nahhao74/QUIZ_Remote/hardware/schematic/M1_BATTERY_MAIN_SWITCH.png

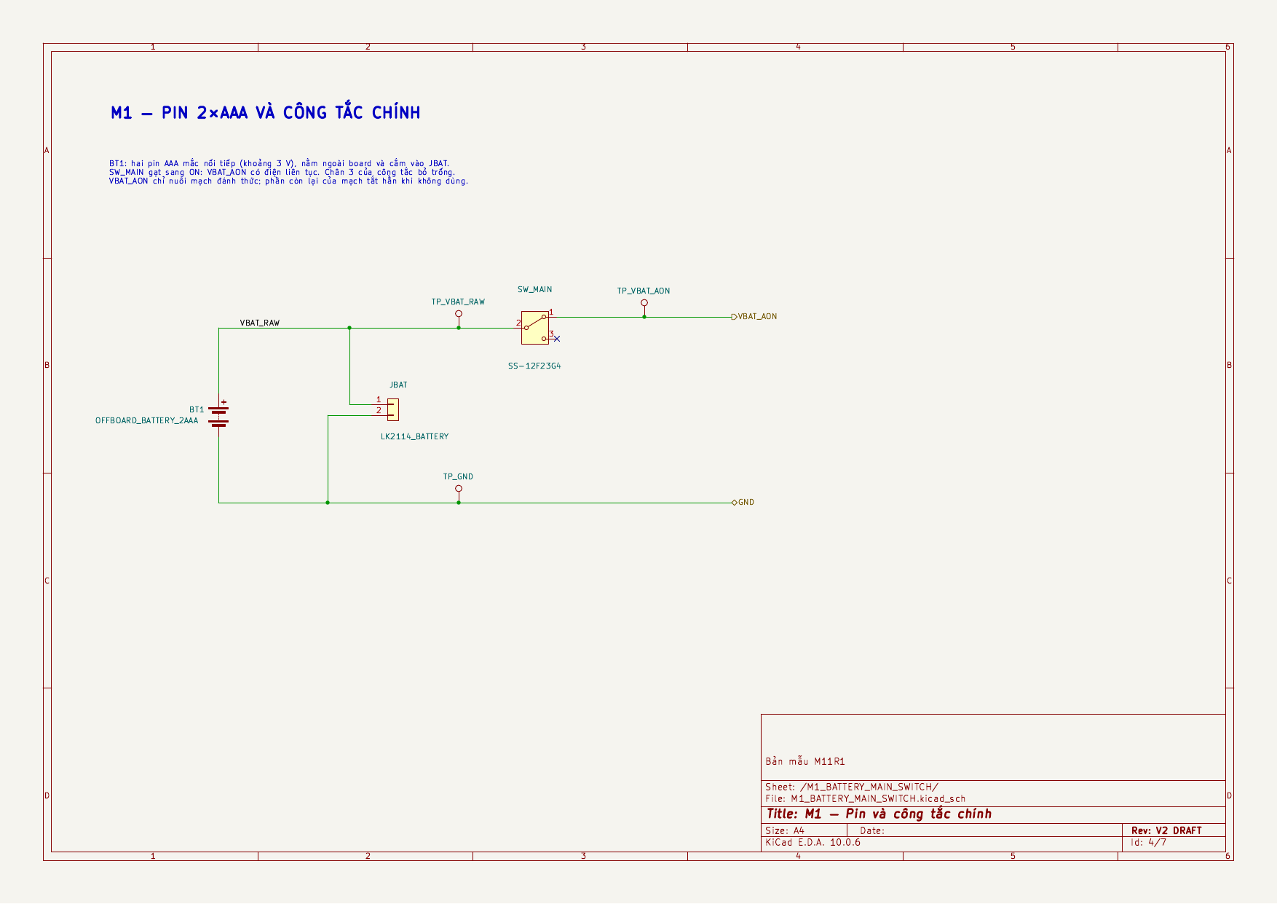
hardware/schematic/M1_BATTERY_MAIN_SWITCH.png
