nahhao74/QUIZ_Remote/hardware/schematic/M2_POWER_GATE_WAKE_HOLD.png

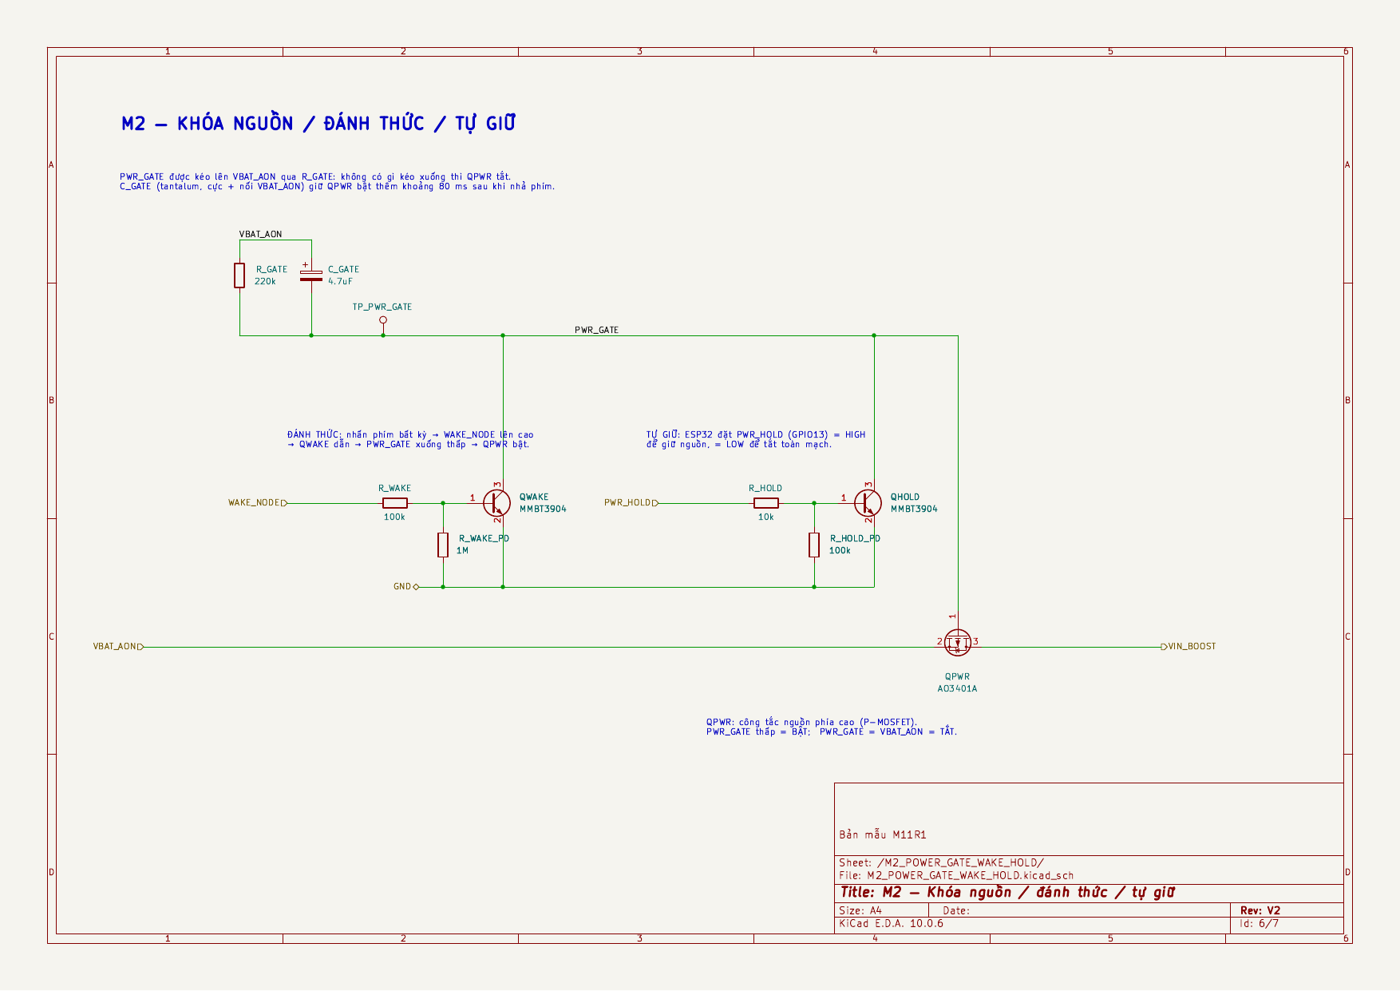
hardware/schematic/M2_POWER_GATE_WAKE_HOLD.png
