nahhao74/QUIZ_Remote/hardware/schematic/M3_BOOST_3V3.png

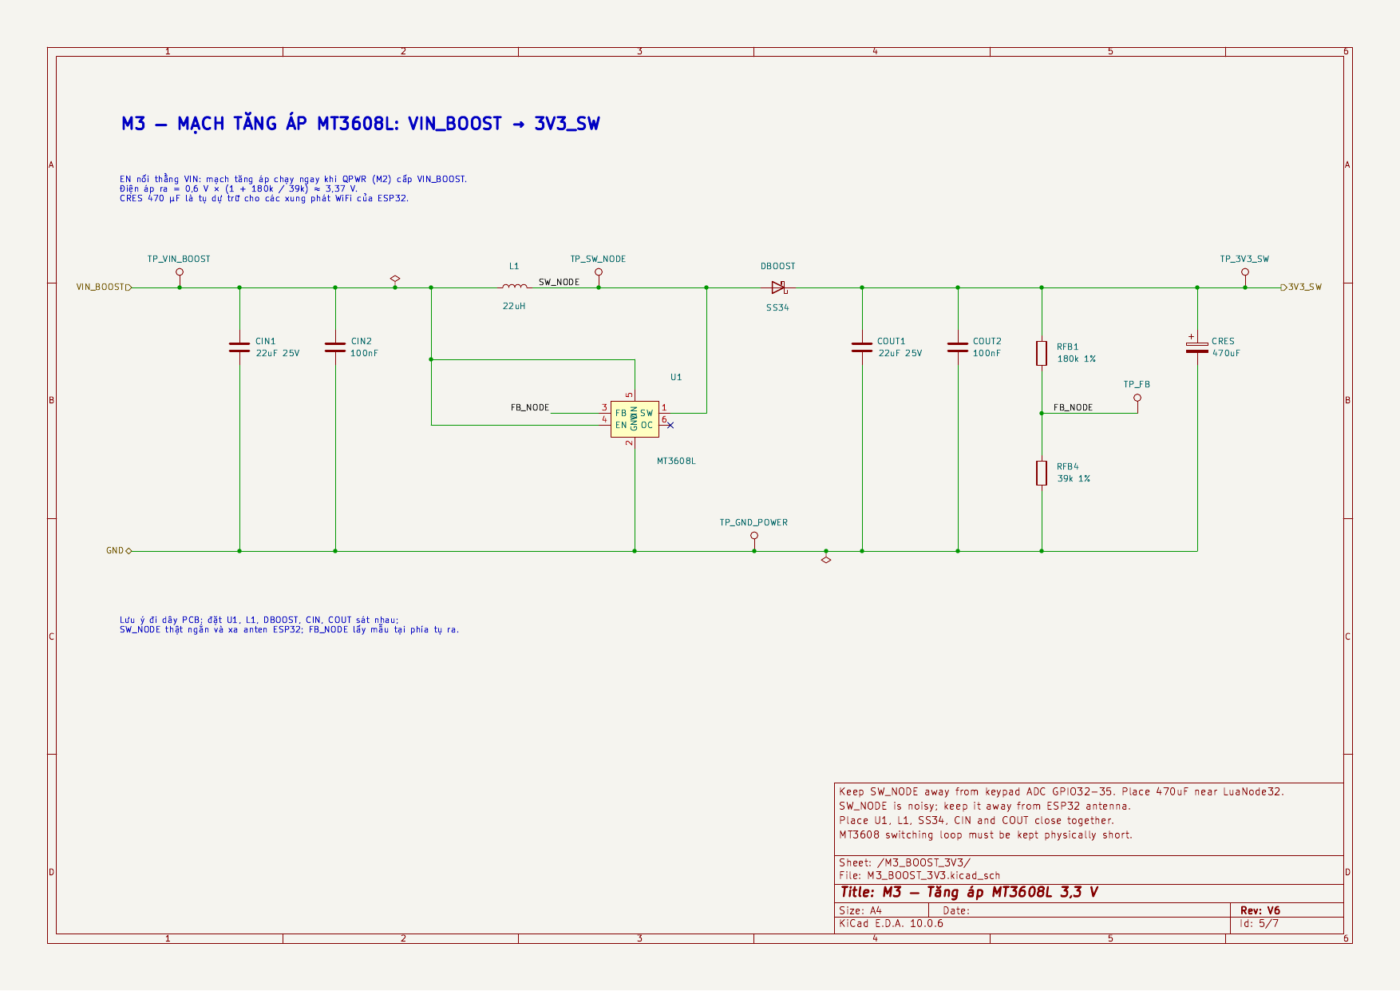
hardware/schematic/M3_BOOST_3V3.png
