nahhao74/QUIZ_Remote/hardware/schematic/M4_ESP32_SOCKET.png

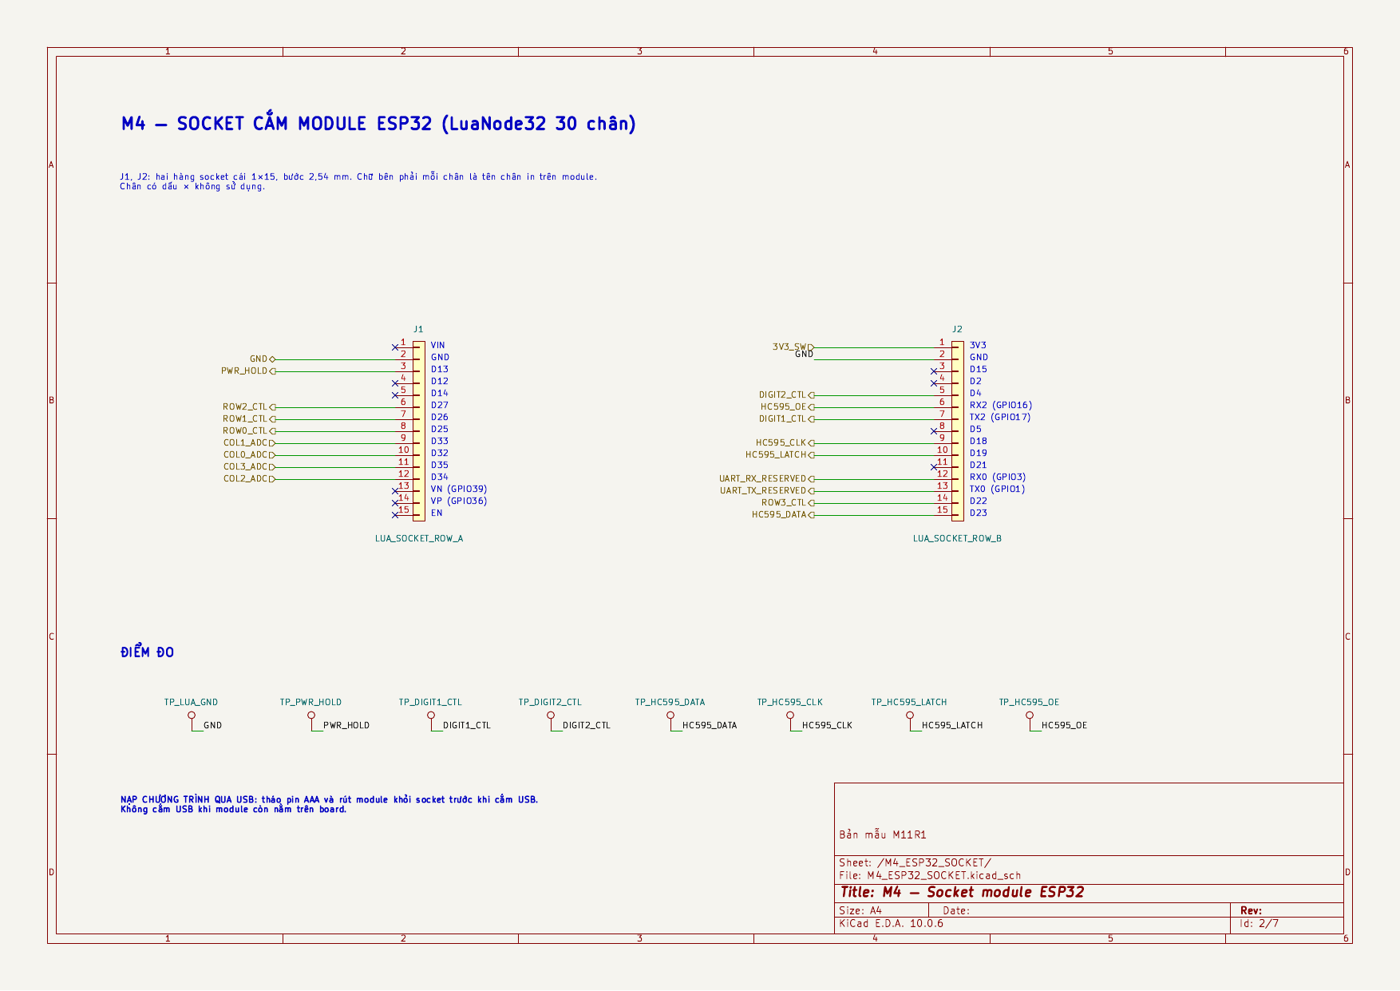
hardware/schematic/M4_ESP32_SOCKET.png
