nahhao74/QUIZ_Remote/hardware/schematic/M5_KEYPAD_4X4.png

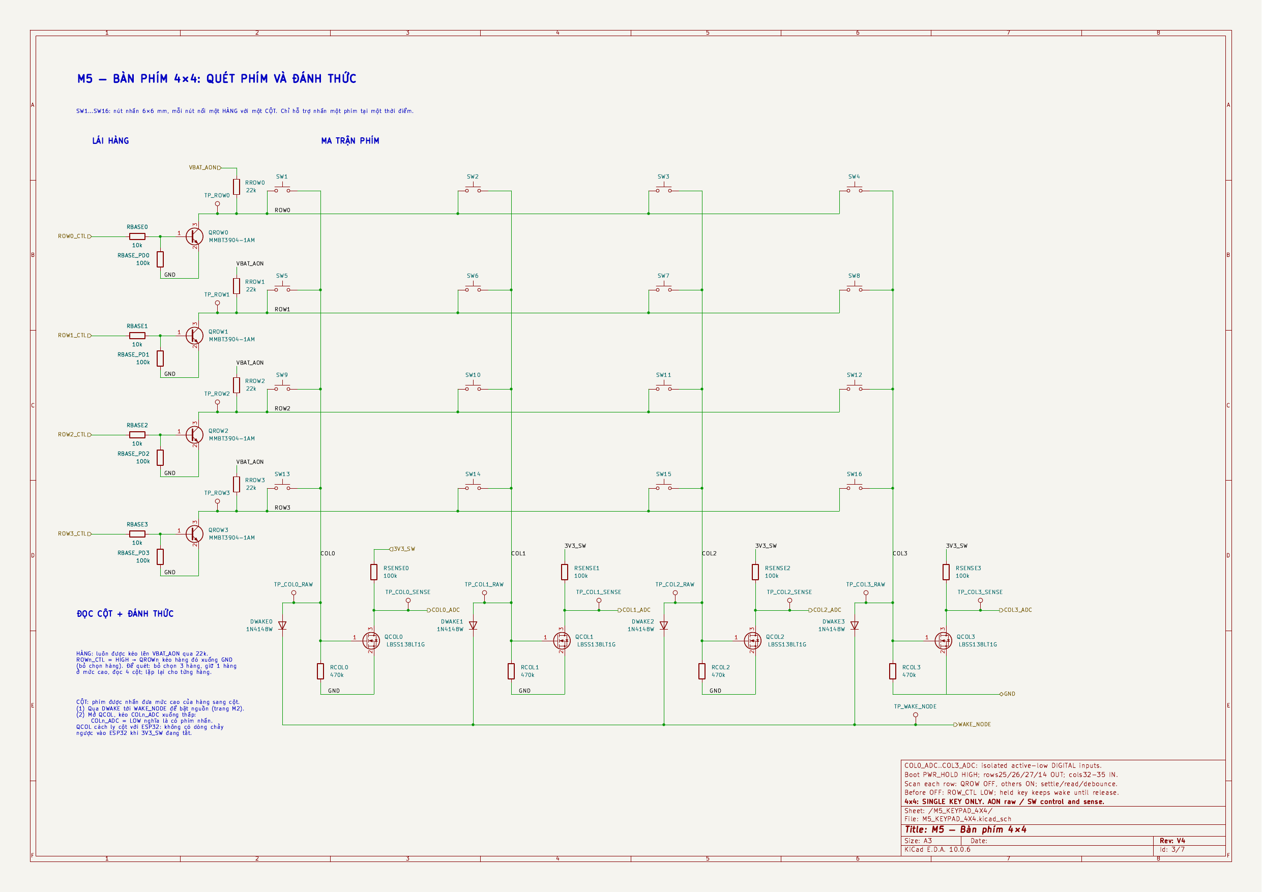
hardware/schematic/M5_KEYPAD_4X4.png
