nahhao74/QUIZ_Remote/hardware/schematic/M6_DISPLAY_2DIGIT.png

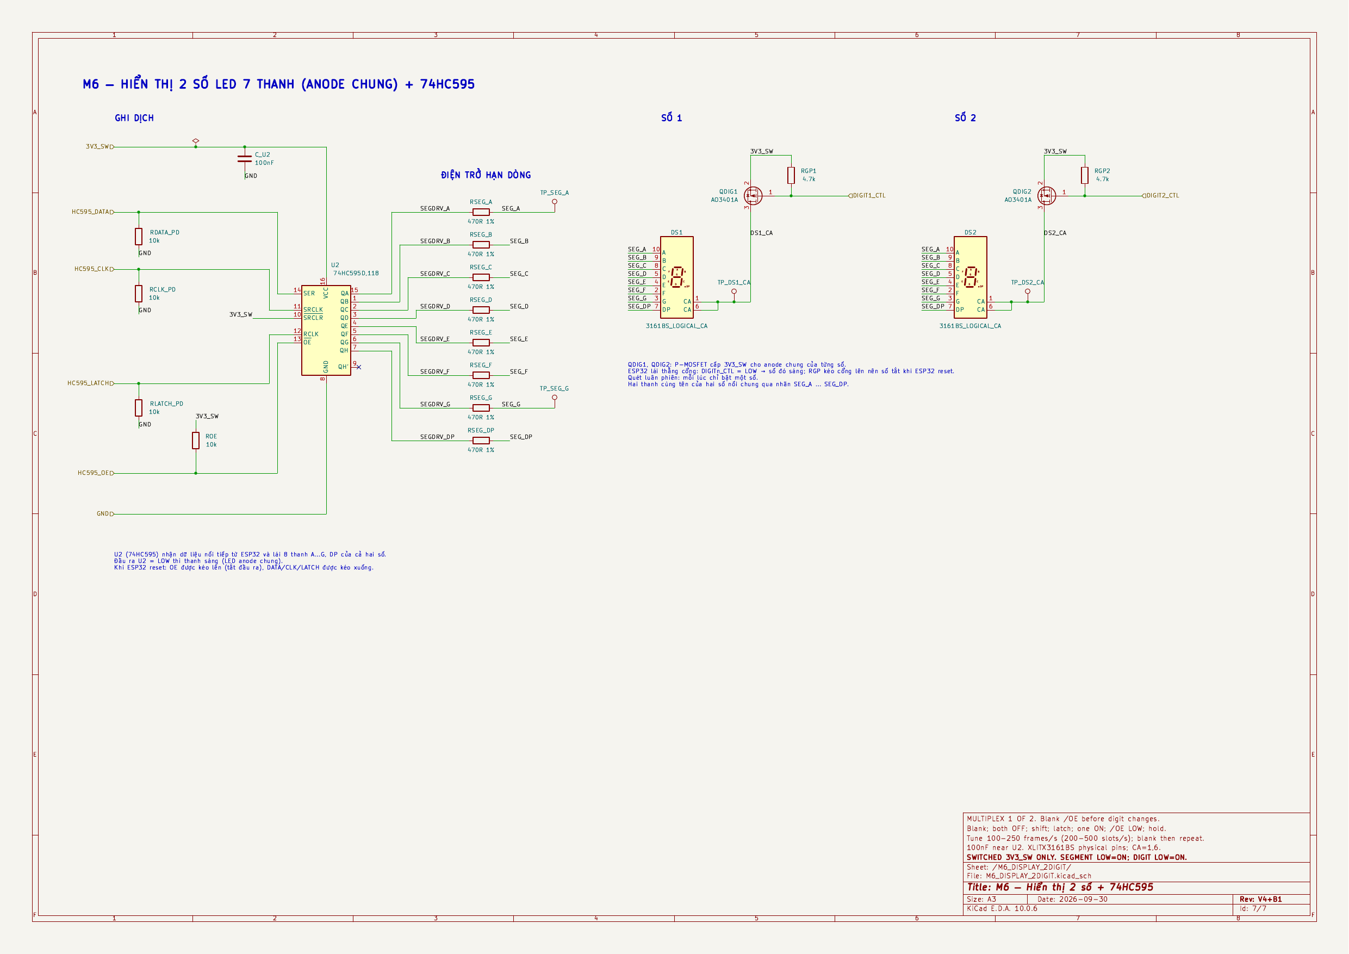
hardware/schematic/M6_DISPLAY_2DIGIT.png
