nahhao74/QUIZ_Remote/hardware/single-layer/exports/pcb-back.png

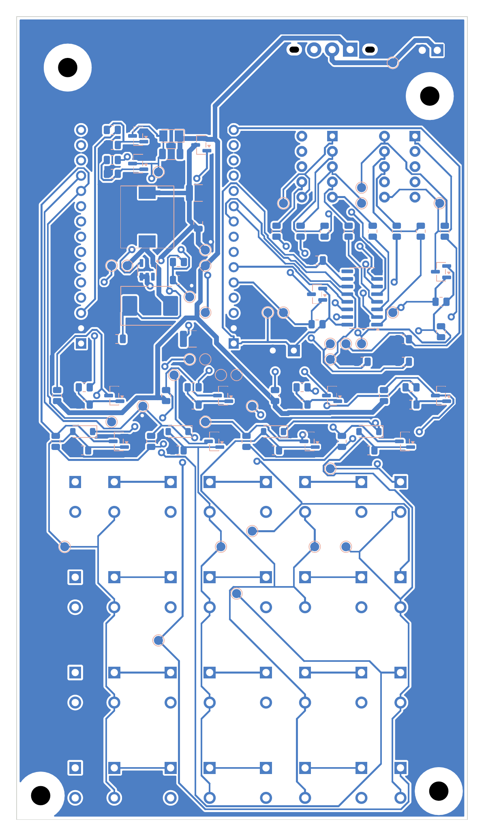
hardware/single-layer/exports/pcb-back.png
