nahhao74/QUIZ_Remote/hardware/single-layer/exports/pcb-front.png

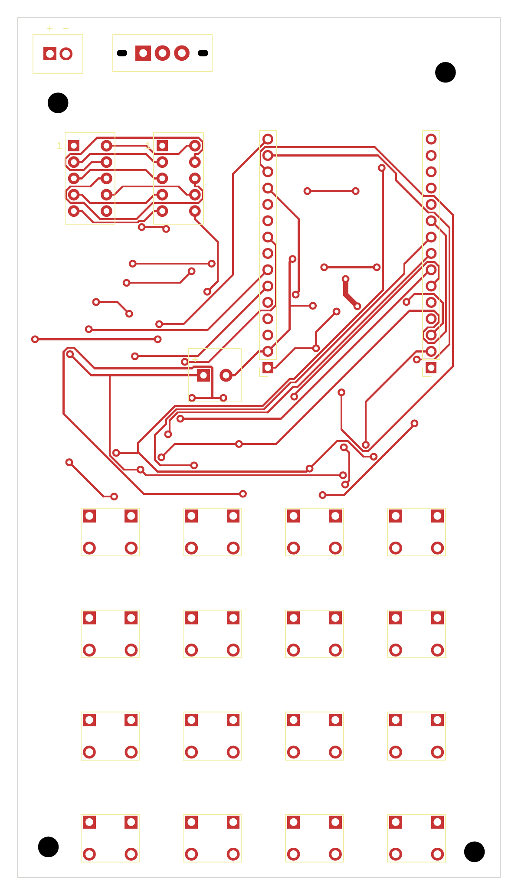
hardware/single-layer/exports/pcb-front.png
