nahhao74/QUIZ_Remote/hardware/single-layer/route/render_back.png

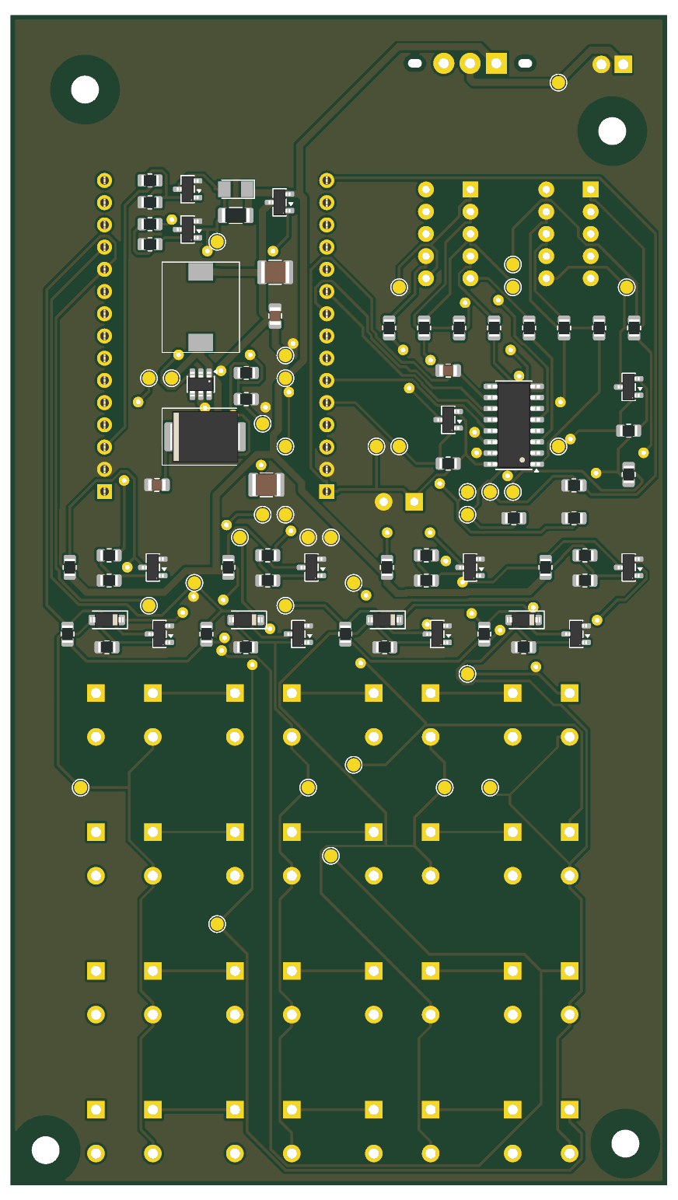
hardware/single-layer/route/render_back.png
