nahhao74/QUIZ_Remote/quiz_remote_1layer/route/jumpers.png

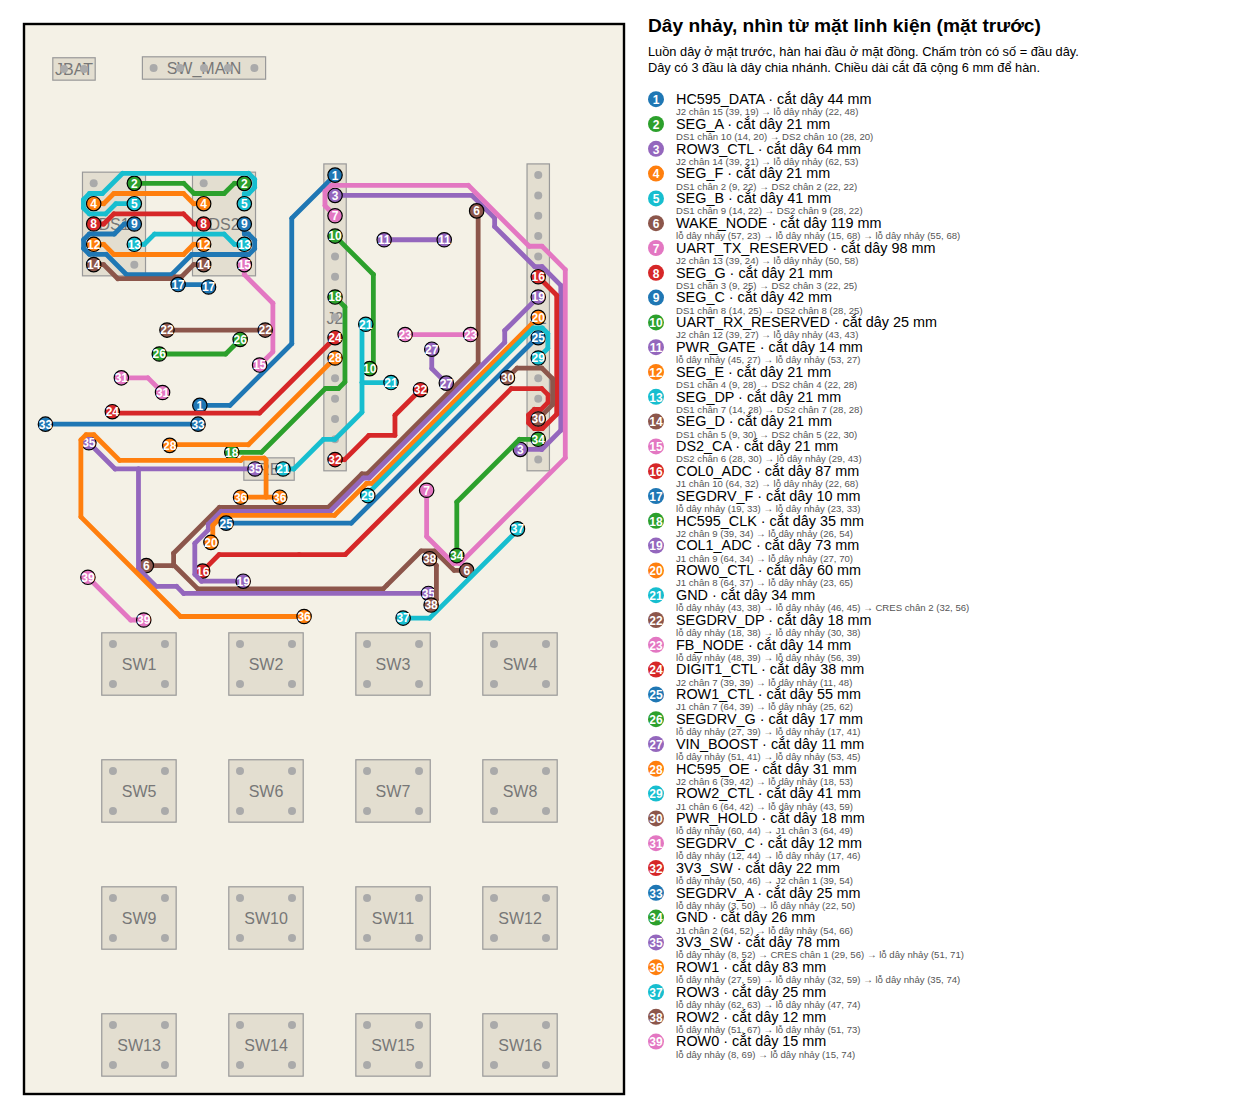
quiz_remote_1layer/route/jumpers.png
