nahhao74/QUIZ_Remote/quiz_remote_1layer/route/render_front.png

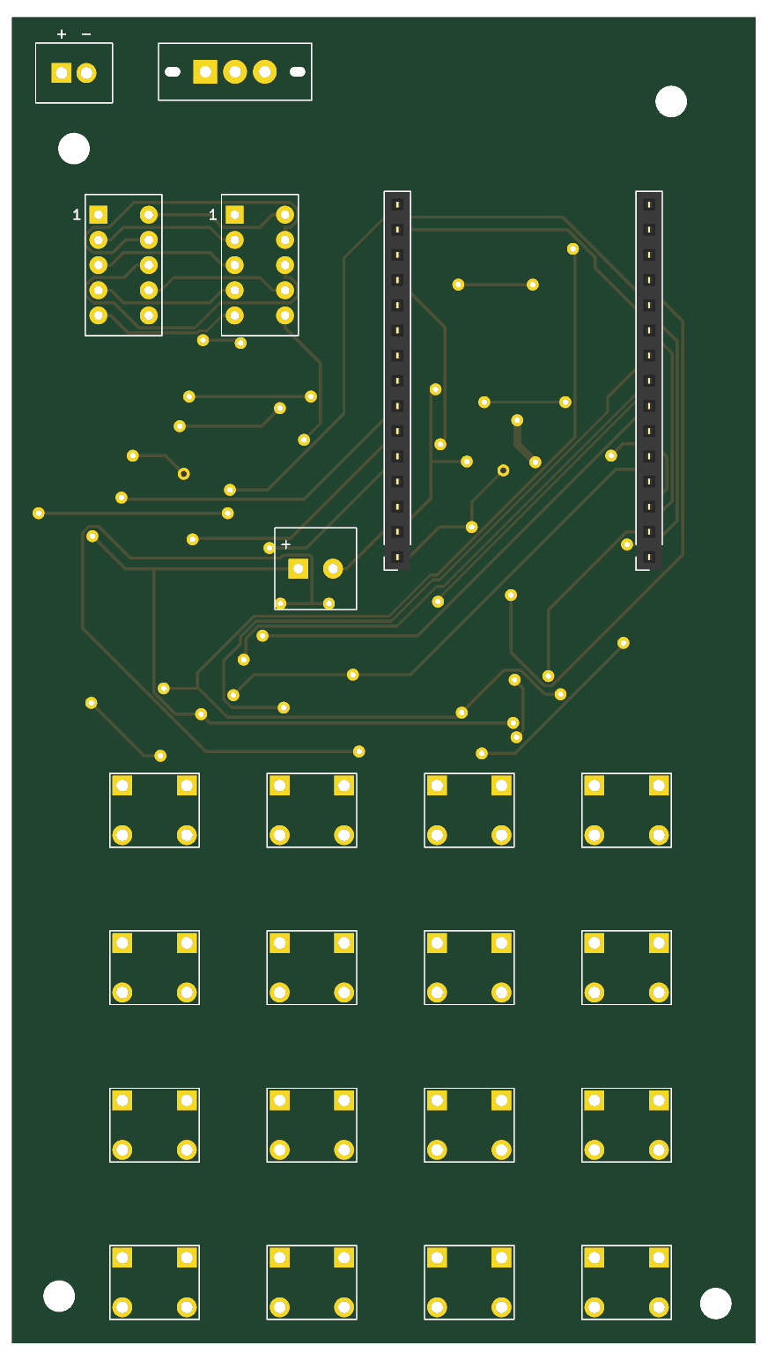
quiz_remote_1layer/route/render_front.png
