nahhao74/QUIZ_Remote/quiz_remote_compact/route/render_front.png

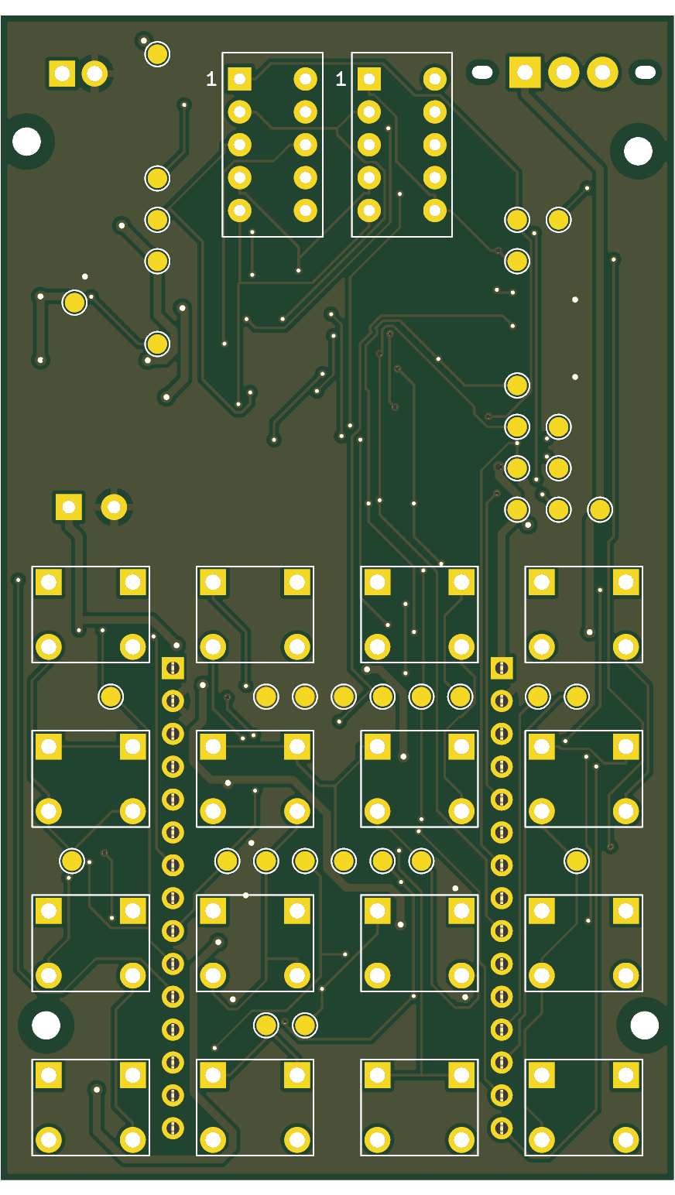
quiz_remote_compact/route/render_front.png
