nahhao74/QUIZ_Remote/hardware/compact/bom.csv

Reference | Value | Footprint | Qty | Datasheet
BT1 | OFFBOARD_BATTERY_2AAA |  | 1 | https://www.thegioiic.com/hop-pin-khay-pin-2xaaa-day-noi-dai-15cm
CIN1,COUT1 | 22uF 25V | Capacitor_SMD:C_1210_3225Metric | 2
CIN2,COUT2,C_U2 | 100nF | Capacitor_SMD:C_0805_2012Metric | 3 | https://search.kemet.com/download/specsheet/C0805C104K5RACTU
CRES? | 470uF | quiz_remote_physical:CRES_IC4172_D8_P3.50_Prototype | 1 | https://www.thegioiic.com/tu-hoa-470uf-16v-8x12-5mm-xuyen-lo
C_GATE? | 4.7uF | quiz_remote_physical:CP_AVX_TAJ_A_3216_18 | 1 | https://datasheets.kyocera-avx.com/TAJ.pdf
DBOOST? | SS34 | Diode_SMD:D_SMC | 1 | https://www.vishay.com/docs/88751/ss32.pdf
DS1,DS2 | 3161BS_LOGICAL_CA | quiz_remote_physical:Display_XLITX_3161BS | 2 | https://www.xlitx.com/datasheet/3161BS.pdf
DWAKE0-DWAKE3 | 1N4148W | Diode_SMD:D_SOD-123 | 4 | https://www.vishay.com/docs/85748/1n4148w.pdf
J1 | LUA_SOCKET_ROW_A | Connector_PinSocket_2.54mm:PinSocket_1x15_P2.54mm_Vertical | 1
J2 | LUA_SOCKET_ROW_B | Connector_PinSocket_2.54mm:PinSocket_1x15_P2.54mm_Vertical | 1
JBAT? | LK2114_BATTERY | quiz_remote_physical:JBAT_LK2114_P2.50_Prototype | 1 | https://file.linhkienx.com/upload/large/4576.jpg
L1 | 22uH | quiz_remote_physical:L_8D43_220_ThegioiIC | 1 | https://file.thegioiic.com/upload/large/3406.jpg
QCOL0-QCOL3 | LBSS138LT1G | Package_TO_SOT_SMD:SOT-23 | 4 | https://www.lrc.cn/Upload/PDF/Product/MOS/LBSS138LT1G.pdf
QDIG1,QDIG2,QPWR? | AO3401A | Package_TO_SOT_SMD:SOT-23 | 3 | https://www.aosmd.com/res/data_sheets/AO3401A.pdf
QHOLD?,QWAKE? | MMBT3904 | Package_TO_SOT_SMD:SOT-23 | 2 | https://assets.nexperia.com/documents/data-sheet/MMBT3904.pdf
QROW0-QROW3 | MMBT3904-1AM | Package_TO_SOT_SMD:SOT-23 | 4 | https://assets.nexperia.com/documents/data-sheet/MMBT3904.pdf
RBASE0-RBASE3,RCLK_PD?,RDATA_PD?,RLATCH_PD?,ROE?,R_HOLD? | 10k | Resistor_SMD:R_0805_2012Metric | 9 | https://www.kstmicro.com/wp-content/uploads/2024/07/PYu-RC_Group_51_RoHS_L_12-14.pdf
RBASE_PD0-RBASE_PD3,RSENSE0-RSENSE3,R_HOLD_PD?,R_WAKE? | 100k | Resistor_SMD:R_0805_2012Metric | 10 | https://www.kstmicro.com/wp-content/uploads/2024/07/PYu-RC_Group_51_RoHS_L_12-14.pdf
RCOL0-RCOL3 | 470k | Resistor_SMD:R_0805_2012Metric | 4 | https://www.kstmicro.com/wp-content/uploads/2024/07/PYu-RC_Group_51_RoHS_L_12-14.pdf
RFB1 | 180k 1% | Resistor_SMD:R_0805_2012Metric | 1 | https://www.kstmicro.com/wp-content/uploads/2024/07/PYu-RC_Group_51_RoHS_L_12-14.pdf
RFB4 | 39k 1% | Resistor_SMD:R_0805_2012Metric | 1 | https://www.kstmicro.com/wp-content/uploads/2024/07/PYu-RC_Group_51_RoHS_L_12-14.pdf
RGP1,RGP2 | 4.7k | Resistor_SMD:R_0805_2012Metric | 2 | https://www.kstmicro.com/wp-content/uploads/2024/07/PYu-RC_Group_51_RoHS_L_12-14.pdf
RROW0-RROW3 | 22k | Resistor_SMD:R_0805_2012Metric | 4 | https://www.kstmicro.com/wp-content/uploads/2024/07/PYu-RC_Group_51_RoHS_L_12-14.pdf
RSEG_A?,RSEG_B?,RSEG_C?,RSEG_D?,RSEG_DP?,RSEG_E?,RSEG_F?,RSEG_G? | 470R 1% | Resistor_SMD:R_0805_2012Metric | 8 | https://www.kstmicro.com/wp-content/uploads/2024/07/PYu-RC_Group_51_RoHS_L_12-14.pdf
R_GATE? | 220k | Resistor_SMD:R_1206_3216Metric | 1 | https://www.kstmicro.com/wp-content/uploads/2024/07/PYu-RC_Group_51_RoHS_L_12-14.pdf
R_WAKE_PD? | 1M | Resistor_SMD:R_0805_2012Metric | 1 | https://www.kstmicro.com/wp-content/uploads/2024/07/PYu-RC_Group_51_RoHS_L_12-14.pdf
SW1-SW16 | 6x6_THT_NO | quiz_remote_physical:SW_6x6_H4.3_LK14489 | 16 | https://file.linhkienx.com/upload/large/12028.jpg
SW_MAIN? | SS-12F23G4 | quiz_remote_physical:SW_SS12F23G4_LK | 1 | https://file.linhkienx.com/upload/large/1343.jpg
U1 | MT3608L | Package_TO_SOT_SMD:SOT-23-6 | 1 | https://datasheet.lcsc.com/datasheet/pdf/28bde6b2f6a53c067ef18a25e9ffed22.pdf?productCode=C2932326
U2 | 74HC595D,118 | Package_SO:SOIC-16_3.9x9.9mm_P1.27mm | 1 | https://assets.nexperia.com/documents/data-sheet/74HC_HCT595.pdf
