nahhao74/QUIZ_Remote/web/docs/hardware/bom-breadboard.csv

Ref | Quantity | Component | Value / type | Notes
U1 | 1 | ESP32 DevKit 30 pin | ESP32-WROOM-32 | Already owned
DISP1-DISP2 | 2 | 4-digit 7-segment LED module | 74HC595 5-pin | Already owned; VCC 3V3 for testing
K1 | 1 | 4x4 membrane keypad | 8 wires | Already owned
LED1 | 1 | Red LED | SMD 0805 | Add when building the full circuit
LED2 | 1 | Green LED | SMD 0805 or through-hole | Already owned
R1-R4 | 4 | Keypad row protection resistor | 1 kOhm 1/4 W | For the full circuit
R5-R8 | 4 | Keypad column pull-down resistor | 47 kOhm 1/4 W | For the full circuit
R9-R10 | 2 | LED series resistor | 1 kOhm 1/4 W; temporarily 330 Ohm for the green LED | One per LED
C1 | 1 | Power input bulk capacitor | 470 uF 10 V | Recommended near the two displays
C2-C3 | 2 | Decoupling capacitor | 100 nF 50 V | Place near the VCC of each display if the module does not have one
BUF1 | 1 | Optional logic level buffer | 74AHCT125 | Only needed if the displays are powered from 5 V
PS1 | 1 | USB power supply | 5 V at least 1 A | Powers the ESP32; take 3V3 from the board when testing
J1 | 1 | Keypad header | 1x8 2.54 mm | For breadboard/PCB
J2-J3 | 2 | Display header | 1x5 2.54 mm | In the order printed on the module
