nahhao74/QUIZ_Remote/hardware/compact/route/solder_back.png

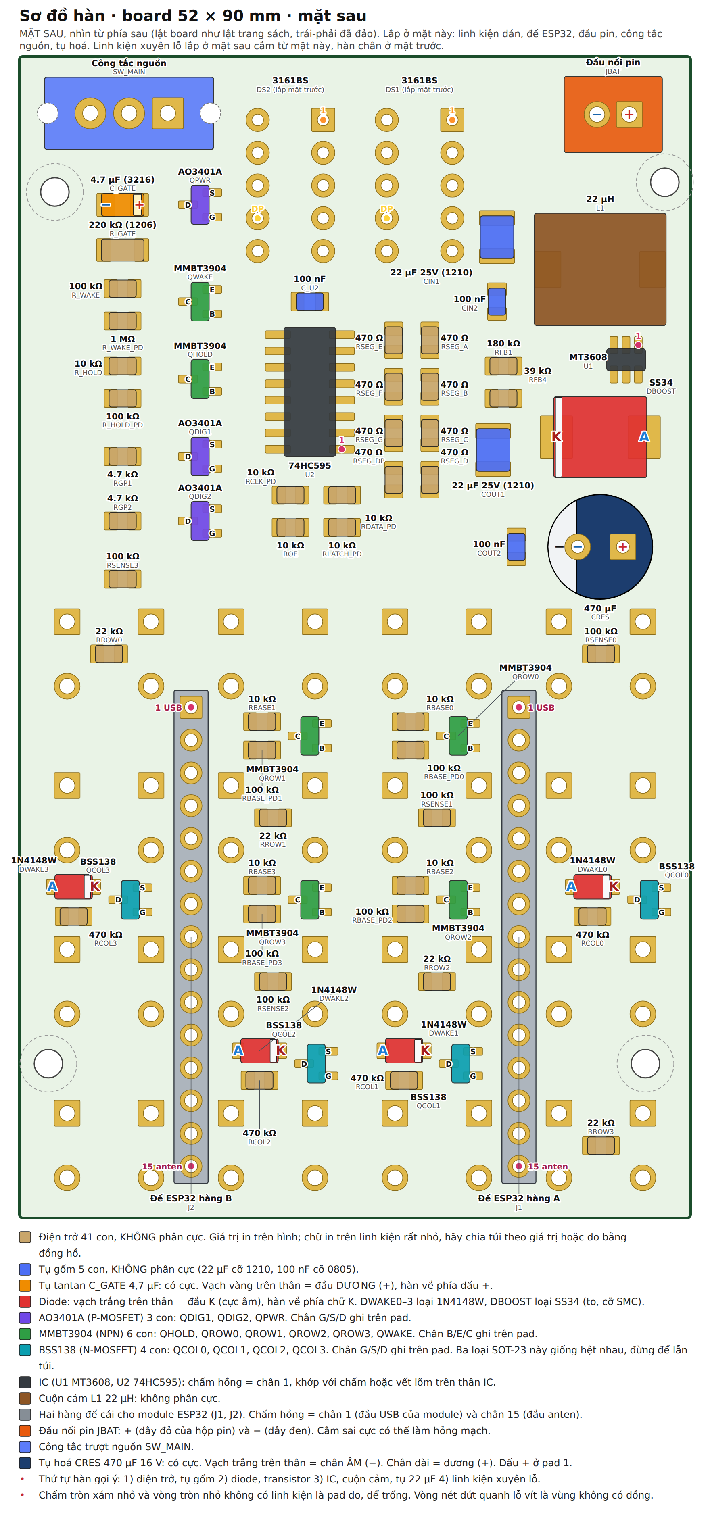
hardware/compact/route/solder_back.png
