nahhao74/QUIZ_Remote/hardware/compact/route/solder_front.png

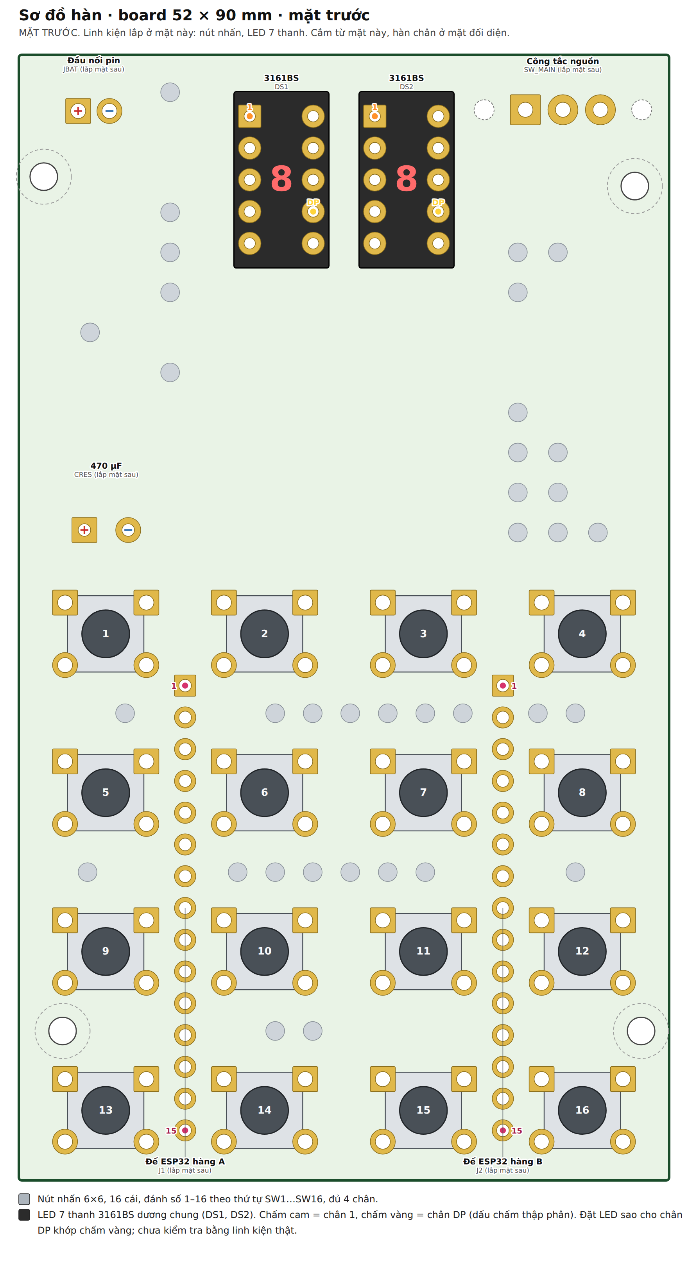
hardware/compact/route/solder_front.png
