nahhao74/QUIZ_Remote/hardware/single-layer/route/solder_back.png

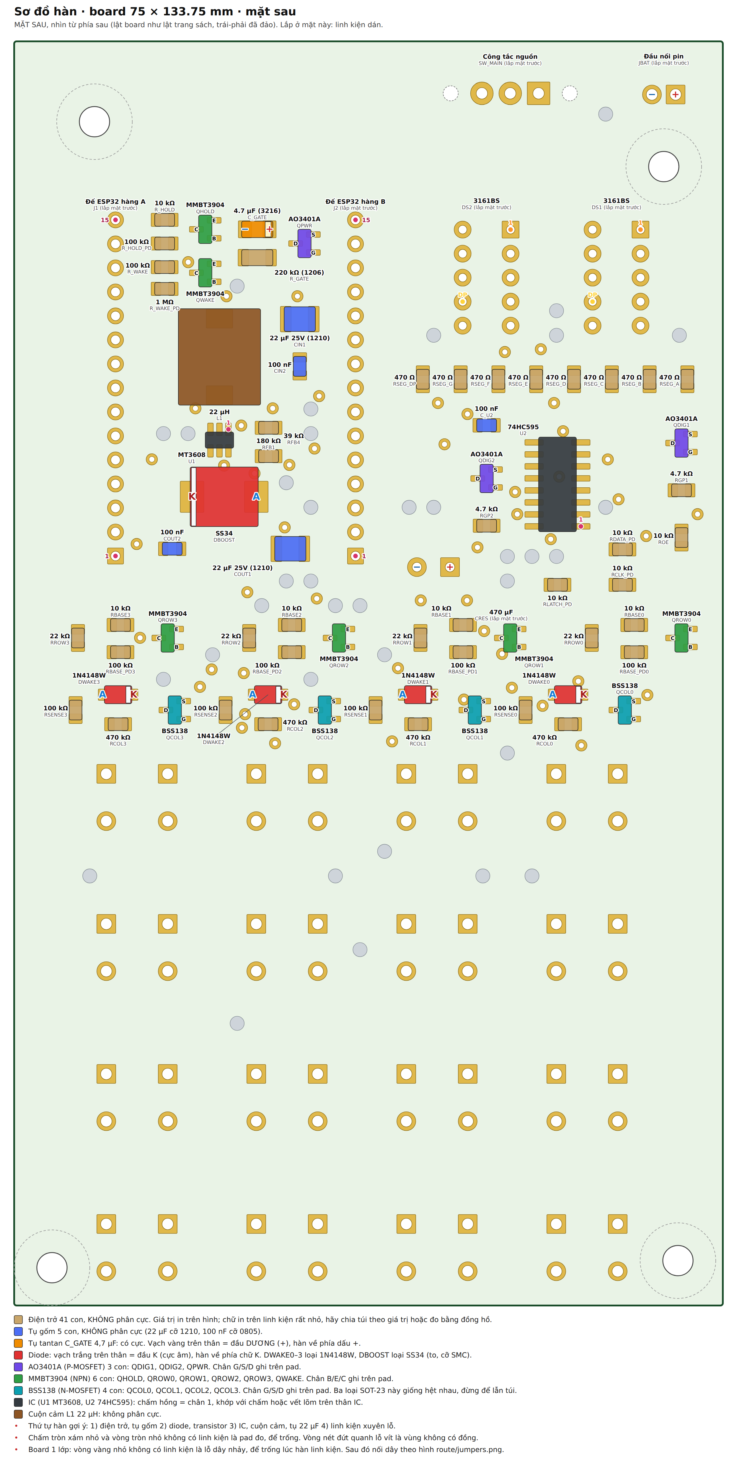
hardware/single-layer/route/solder_back.png
