nahhao74/QUIZ_Remote/hardware/single-layer/route/solder_front.png

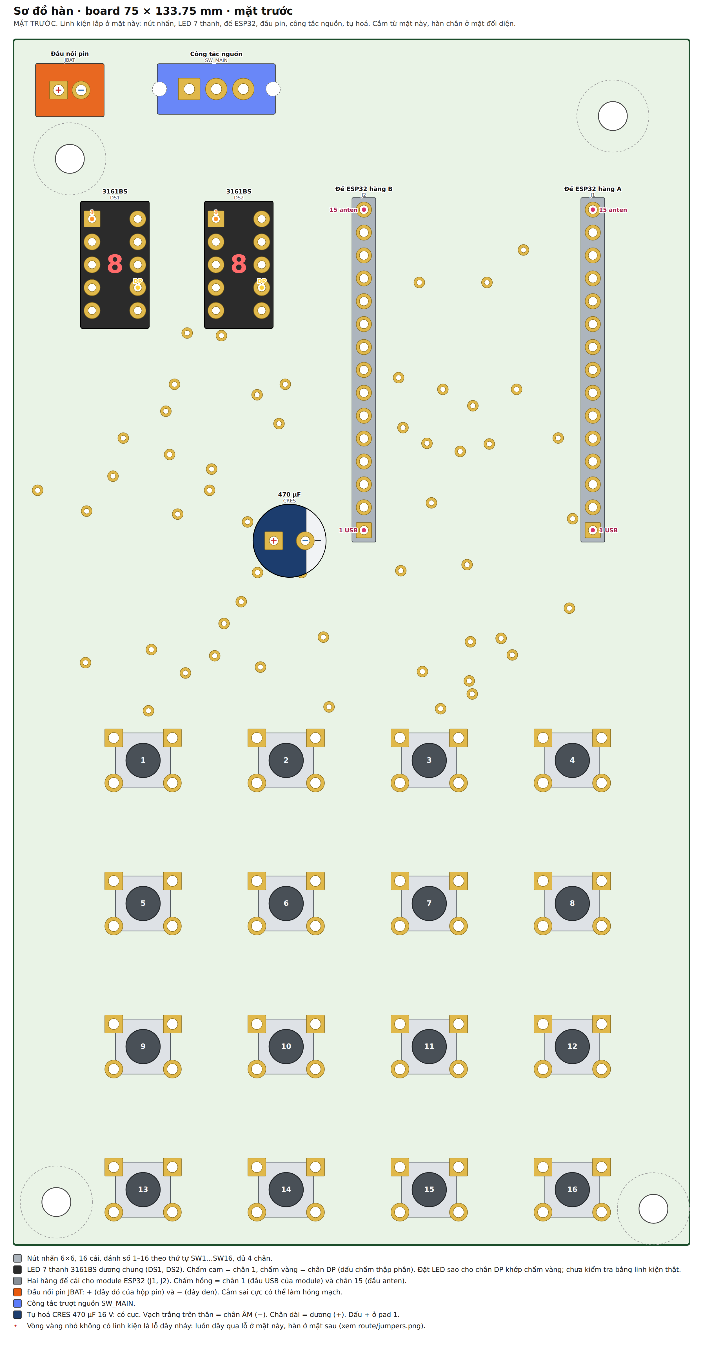
hardware/single-layer/route/solder_front.png
