nahhao74/QUIZ_Remote/hardware/schematic/M1_BATTERY_MAIN_SWITCH.pdf

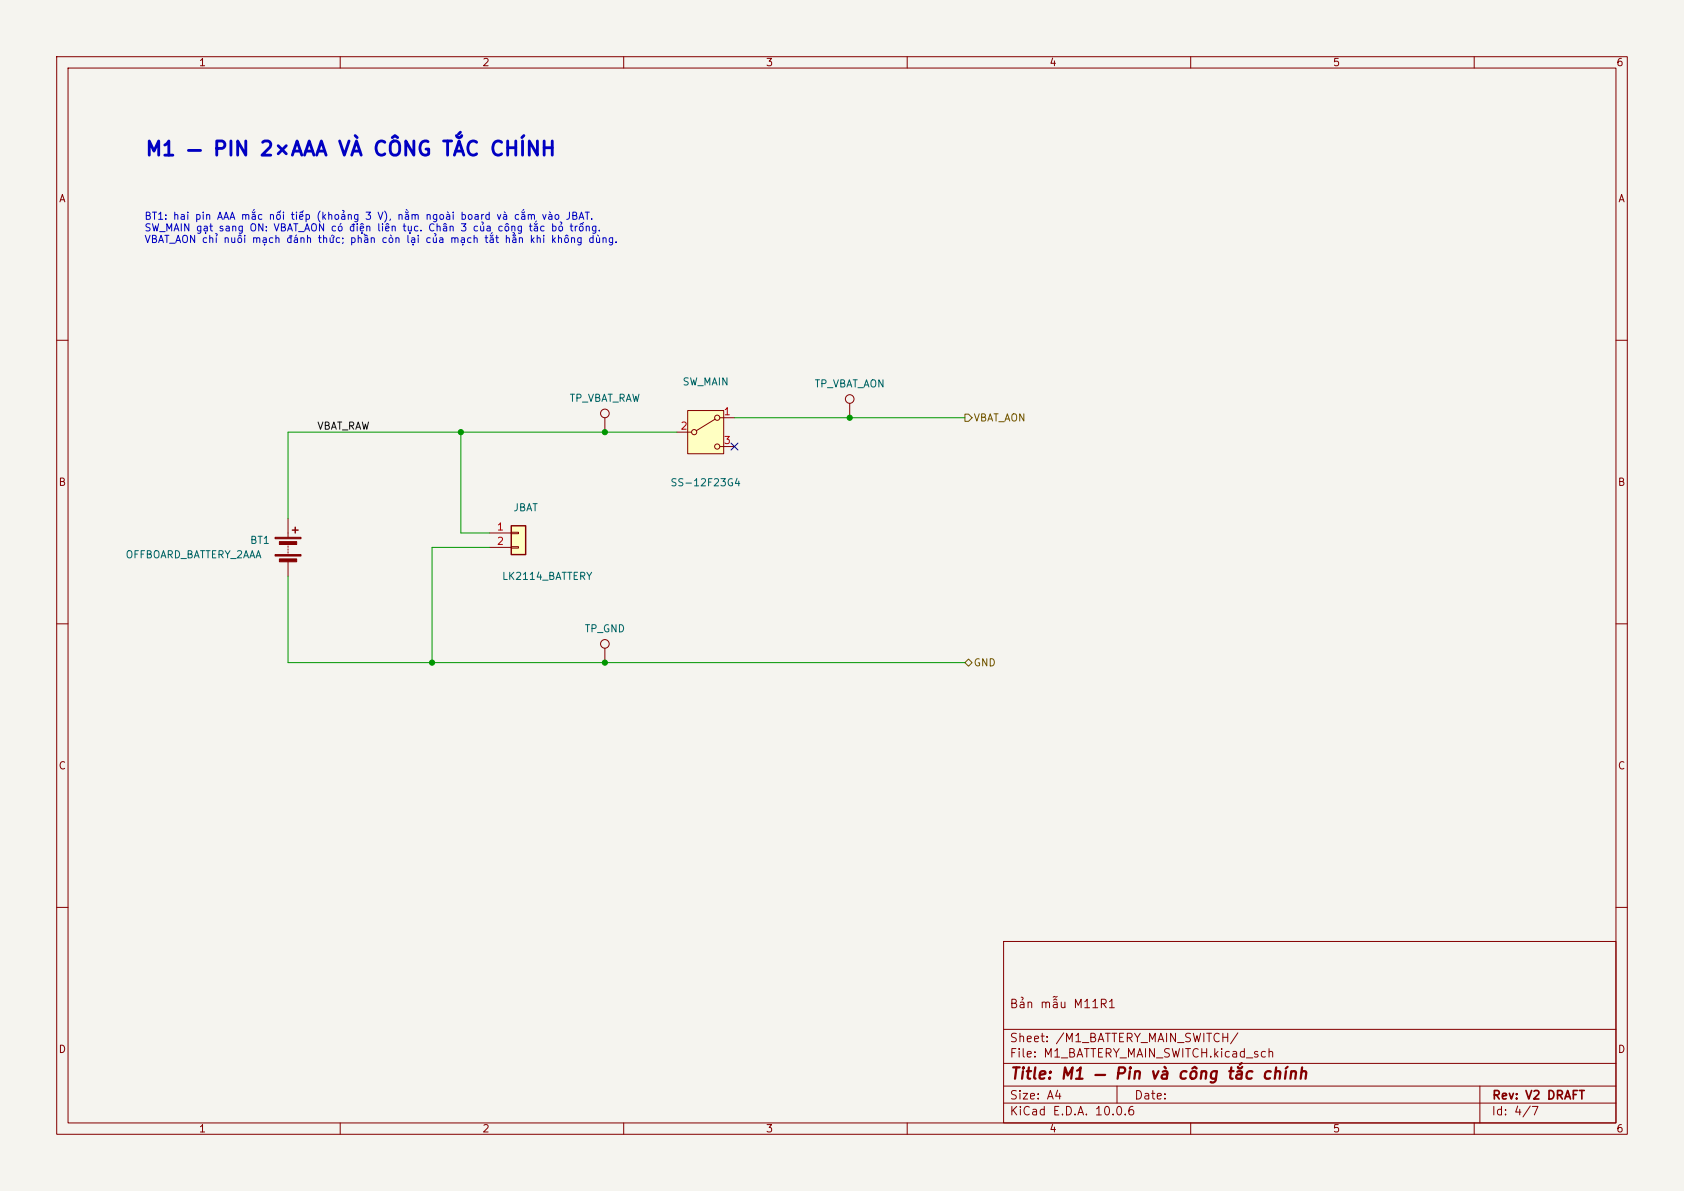
[picture p28: page 1]

VBAT_AON VBAT_RAW M1 — PIN 2×AAA VÀ CÔNG TẮC CHÍNH

BT1: hai pin AAA mắc nối tiếp (khoảng 3 V), nằm ngoài board và cắm vào JBAT. SW_MAIN gạt sang ON: VBAT_AON có điện liên tục. Chân 3 của công tắc bỏ trống. VBAT_AON chỉ nuôi mạch đánh thức; phần còn lại của mạch tắt hẳn khi không dùng.

Sheet: /M1_BATTERY_MAIN_SWITCH/
File: M1_BATTERY_MAIN_SWITCH.kicad_sch
Title: M1 — Pin và công tắc chính

Size: A4 | Rev: V2 DRAFT
KiCad E.D.A. 10.0.6 | Id: 4/7
