nahhao74/QUIZ_Remote/hardware/schematic/M2_POWER_GATE_WAKE_HOLD.pdf

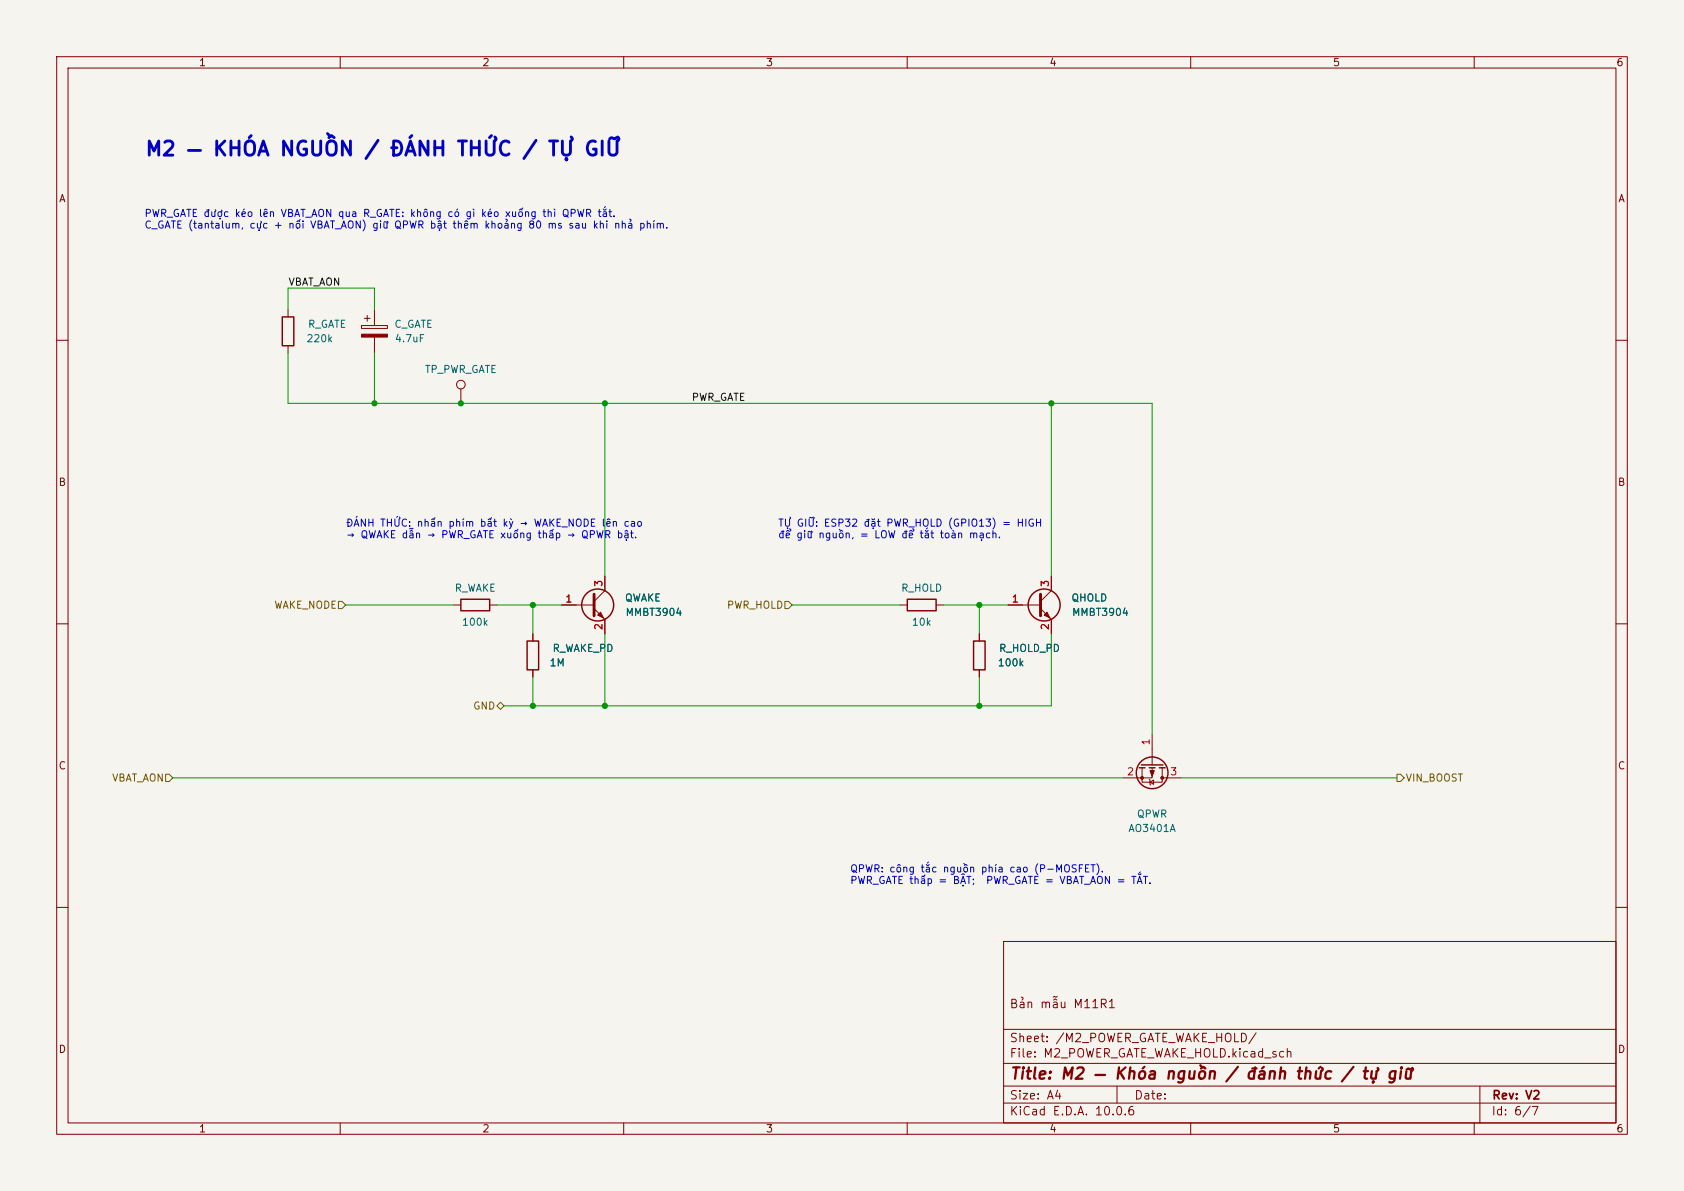
[picture p29: page 1]

M2 — KHÓA NGUỒN / ĐÁNH THỨC / TỰ GIỮ

để giữ nguồn, = LOW để tắt toàn mạch. PWR_GATE được kéo lên VBAT_AON qua R_GATE: không có gì kéo xuống thì QPWR tắt. C_GATE (tantalum, cực + nối VBAT_AON) giữ QPWR bật thêm khoảng 80 ms sau khi nhả phím.

PWR_GATE ĐÁNH THỨC: nhấn phím bất kỳ → WAKE_NODE lên cao → QWAKE dẫn → PWR_GATE xuống thấp → QPWR bật.

TỰ GIỮ: ESP32 đặt PWR_HOLD (GPIO13) = HIGH

Sheet: /M2_POWER_GATE_WAKE_HOLD/
File: M2_POWER_GATE_WAKE_HOLD.kicad_sch
Title: M2 — Khóa nguồn / đánh thức / tự giữ

Size: A4 | Rev: V2
KiCad E.D.A. 10.0.6 | Id: 6/7
