nahhao74/QUIZ_Remote/hardware/schematic/M3_BOOST_3V3.pdf

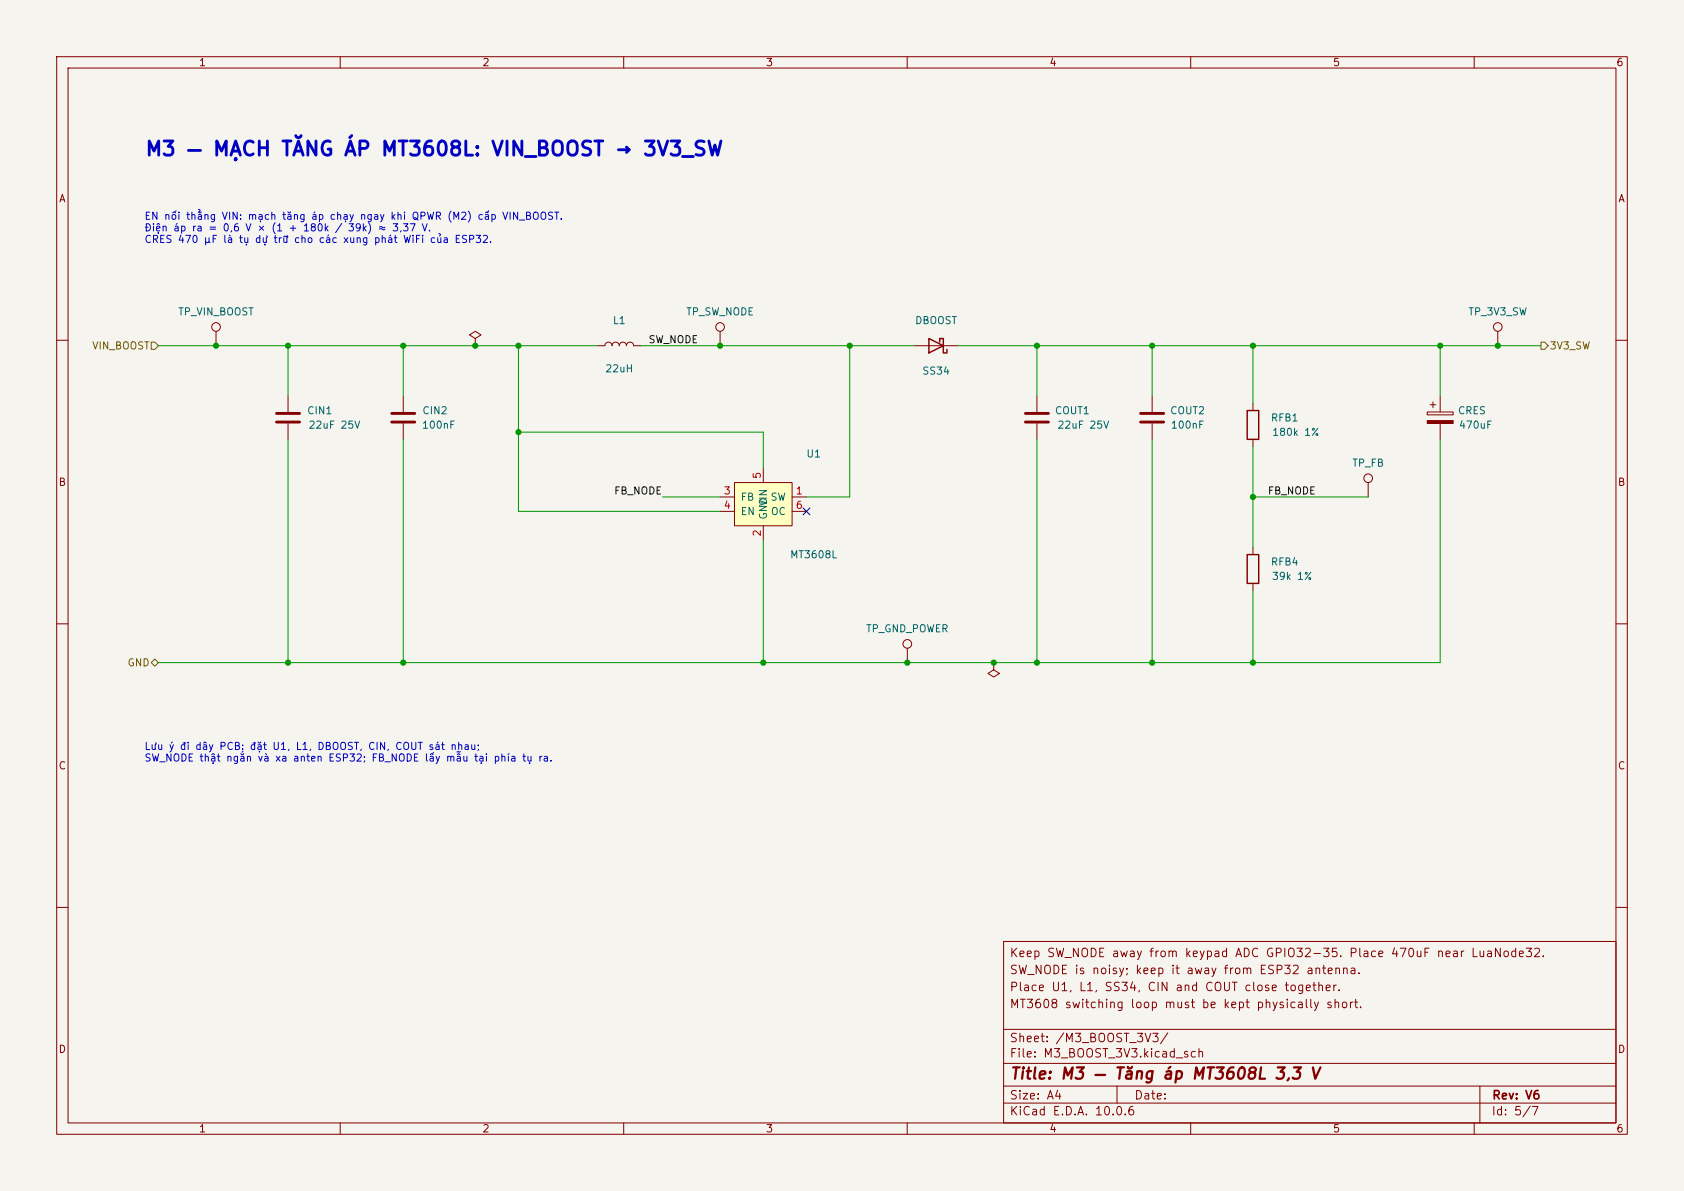
[picture p30: page 1]

EN nối thẳng VIN: mạch tăng áp chạy ngay khi QPWR (M2) cấp VIN_BOOST. Điện áp ra = 0,6 V × (1 + 180k / 39k) ≈ 3,37 V. CRES 470 µF là tụ dự trữ cho các xung phát WiFi của ESP32. M3 — MẠCH TĂNG ÁP MT3608L: VIN_BOOST → 3V3_SW

Lưu ý đi dây PCB: đặt U1, L1, DBOOST, CIN, COUT sát nhau; SW_NODE thật ngắn và xa anten ESP32; FB_NODE lấy mẫu tại phía tụ ra.

Keep SW_NODE away from keypad ADC GPIO32-35. Place 470uF near LuaNode32.
SW_NODE is noisy; keep it away from ESP32 antenna.
Place U1, L1, SS34, CIN and COUT close together.
MT3608 switching loop must be kept physically short.

Size: A4 | Rev: V6
KiCad E.D.A. 10.0.6 | Id: 5/7
