nahhao74/QUIZ_Remote/hardware/schematic/M4_ESP32_SOCKET.pdf

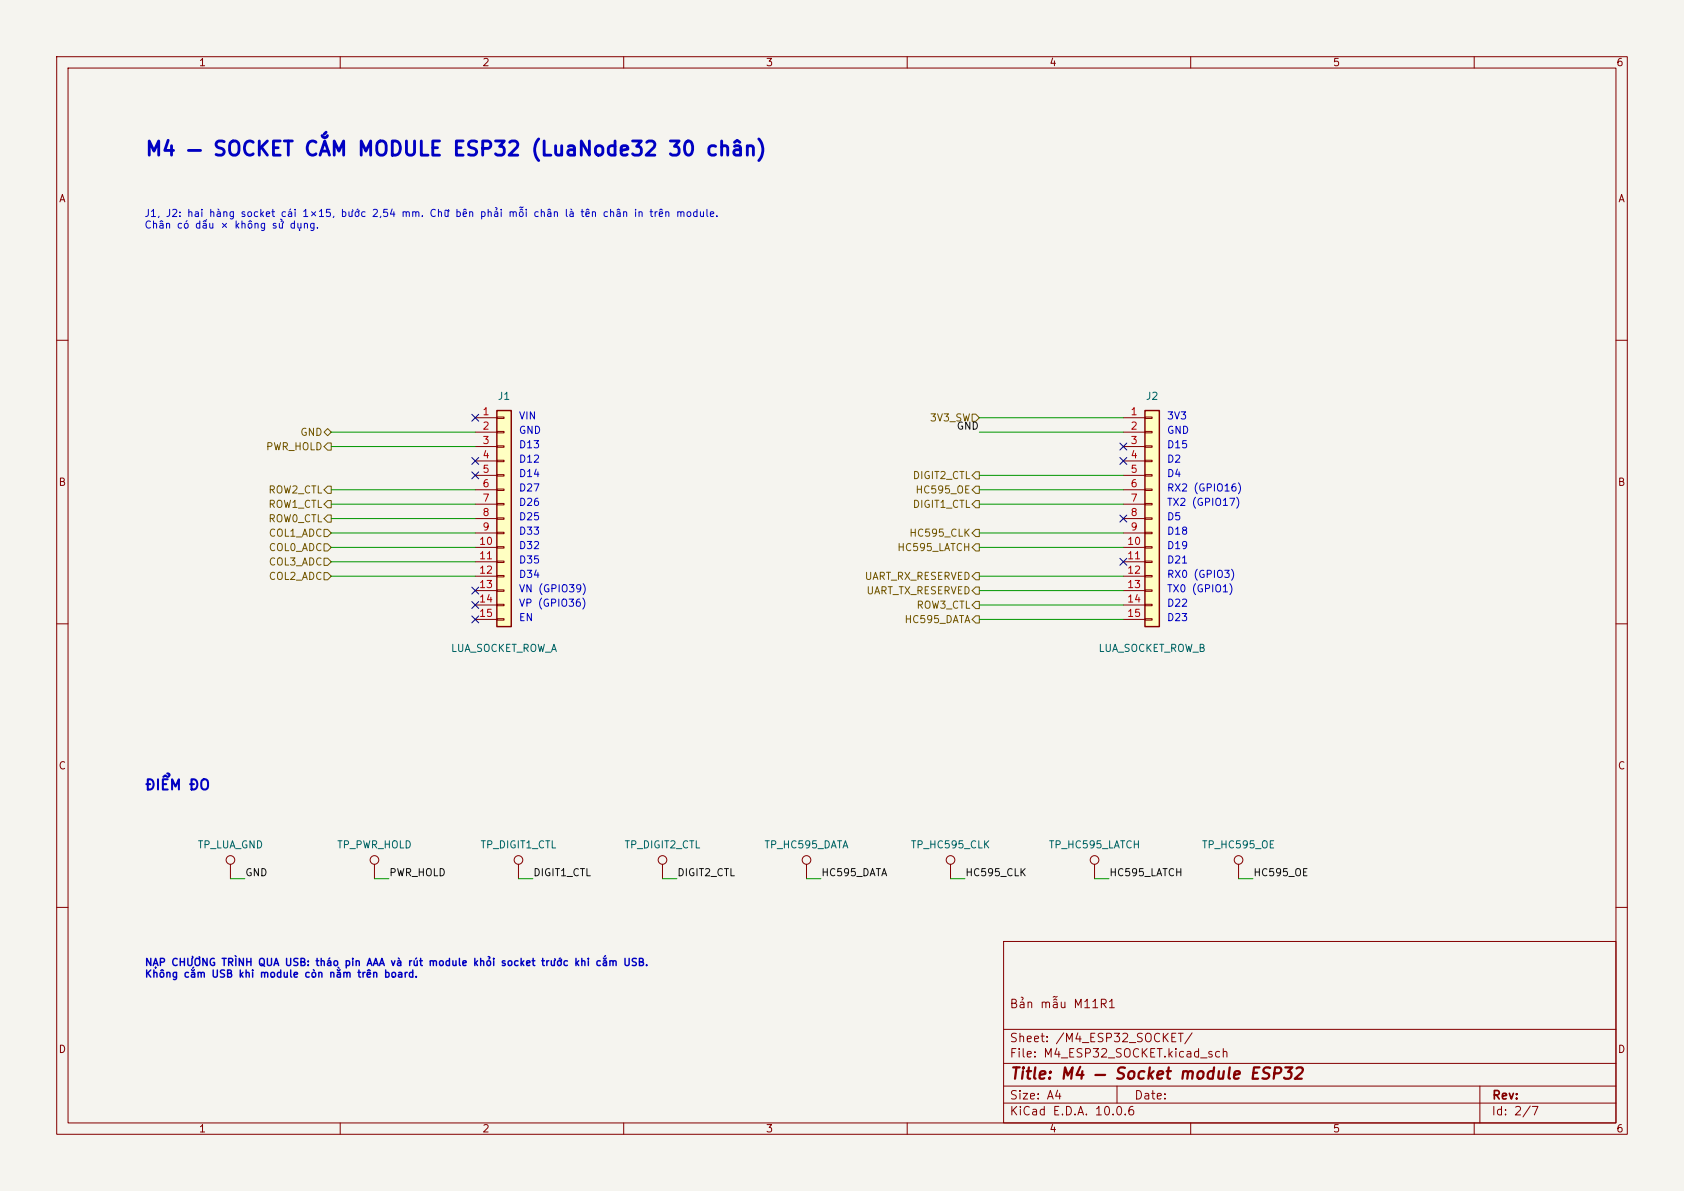
[picture p31: page 1]

M4 — SOCKET CẮM MODULE ESP32 (LuaNode32 30 chân)

J1, J2: hai hàng socket cái 1×15, bước 2,54 mm. Chữ bên phải mỗi chân là tên chân in trên module. Chân có dấu × không sử dụng.

Size: A4 | Rev:
KiCad E.D.A. 10.0.6 | Id: 2/7
