nahhao74/QUIZ_Remote/hardware/schematic/M6_DISPLAY_2DIGIT.pdf

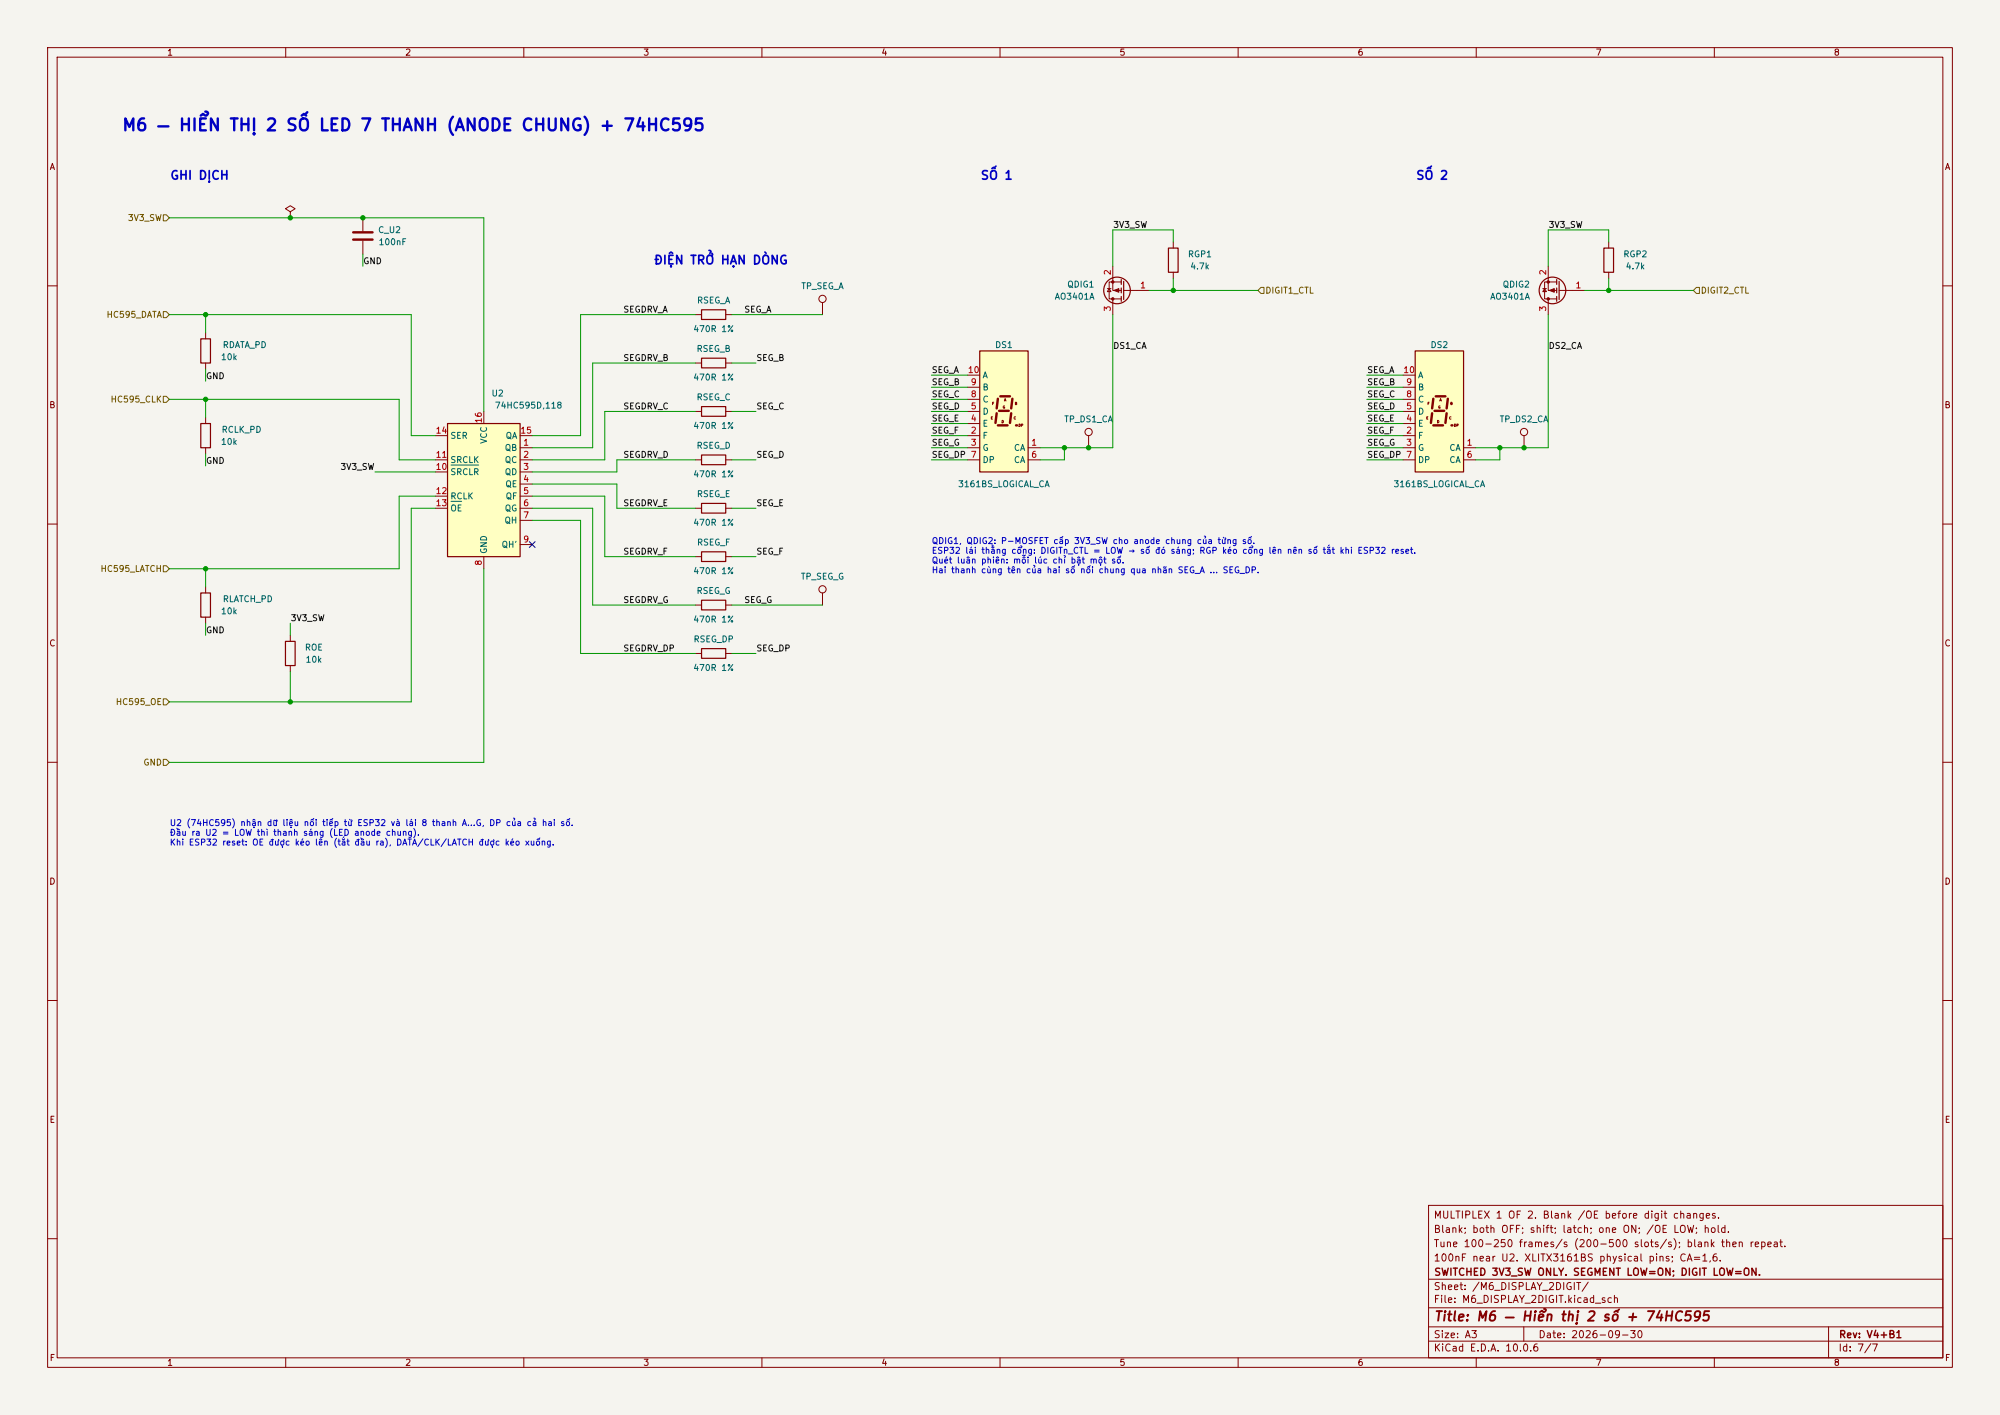
[picture p33: page 1]

M6 — HIỂN THỊ 2 SỐ LED 7 THANH (ANODE CHUNG) + 74HC595

SEG_D ĐIỆN TRỞ HẠN DÒNG

SRCLR 10 SRCLK 11 RCLK 12 OE 13

U2 (74HC595) nhận dữ liệu nối tiếp từ ESP32 và lái 8 thanh A…G, DP của cả hai số.
Đầu ra U2 = LOW thì thanh sáng (LED anode chung). Khi ESP32 reset: OE được kéo lên (tắt đầu ra), DATA/CLK/LATCH được kéo xuống.

MULTIPLEX 1 OF 2. Blank /OE before digit changes.
Blank; both OFF; shift; latch; one ON; /OE LOW; hold.
Tune 100-250 frames/s (200-500 slots/s); blank then repeat.
100nF near U2. XLITX3161BS physical pins; CA=1,6.
SWITCHED 3V3_SW ONLY. SEGMENT LOW=ON; DIGIT LOW=ON.
Sheet: /M6_DISPLAY_2DIGIT/
File: M6_DISPLAY_2DIGIT.kicad_sch
Title: M6 — Hiển thị 2 số + 74HC595

Size: A3 | Rev: V4+B1 | F Date: 2026-09-30
KiCad E.D.A. 10.0.6 | Id: 7/7
