nahhao74/QUIZ_Remote/hardware/schematic/quiz_remote.pdf

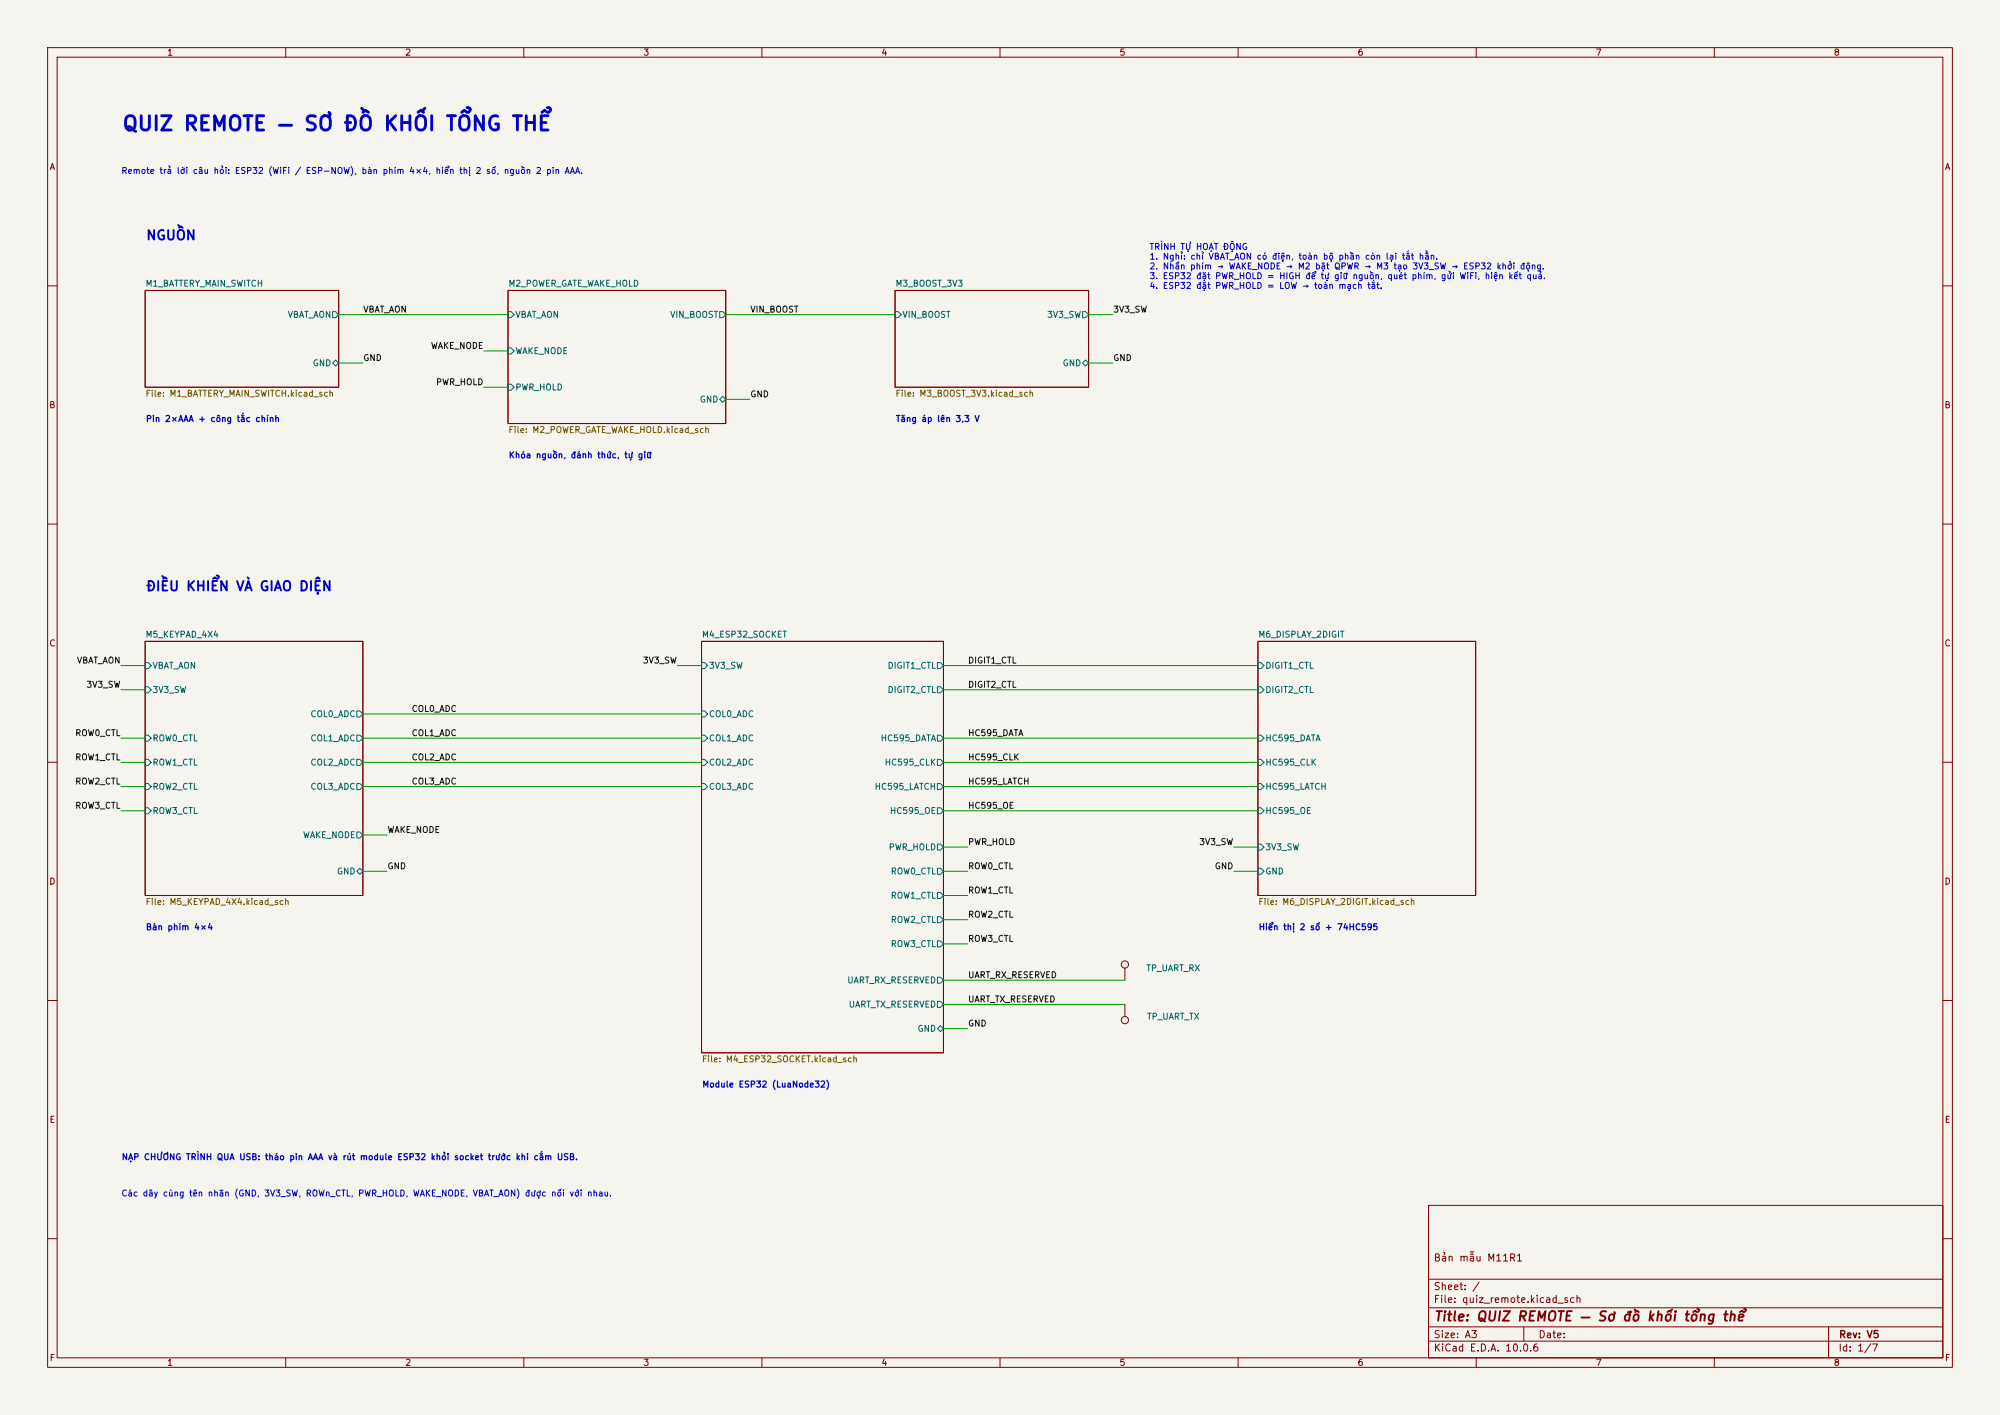
[picture p34: page 1]

QUIZ REMOTE — SƠ ĐỒ KHỐI TỔNG THỂ

Remote trả lời câu hỏi: ESP32 (WiFi / ESP-NOW), bàn phím 4×4, hiển thị 2 số, nguồn 2 pin AAA. NGUỒN

TRÌNH TỰ HOẠT ĐỘNG
1. Nghỉ: chỉ VBAT_AON có điện, toàn bộ phần còn lại tắt hẳn. 2. Nhấn phím → WAKE_NODE → M2 bật QPWR → M3 tạo 3V3_SW → ESP32 khởi động. 3. ESP32 đặt PWR_HOLD = HIGH để tự giữ nguồn, quét phím, gửi WiFi, hiện kết quả. 4. ESP32 đặt PWR_HOLD = LOW → toàn mạch tắt.

Khóa nguồn, đánh thức, tự giữ

NẠP CHƯƠNG TRÌNH QUA USB: tháo pin AAA và rút module ESP32 khỏi socket trước khi cắm USB. Các dây cùng tên nhãn (GND, 3V3_SW, ROWn_CTL, PWR_HOLD, WAKE_NODE, VBAT_AON) được nối với nhau. ĐIỀU KHIỂN VÀ GIAO DIỆN
ROW2_CTL ROW0_CTL VBAT_AON
ROW0_CTL ROW1_CTL ROW2_CTL ROW3_CTL VBAT_AON

Sheet: /
File: quiz_remote.kicad_sch
Title: QUIZ REMOTE — Sơ đồ khối tổng thể

Size: A3 | Rev: V5 | F Date:
KiCad E.D.A. 10.0.6 | Id: 1/7
