nahhao74/QUIZ_Remote/hardware/compact/exports/pcb-back.pdf

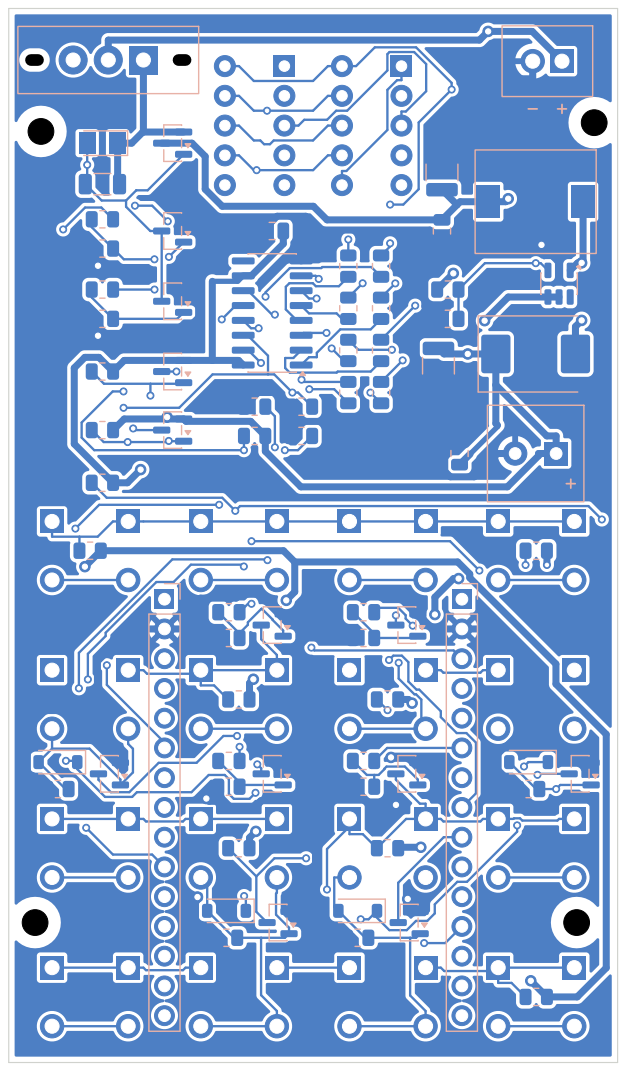
[picture p35: page 1]
