nahhao74/QUIZ_Remote/hardware/compact/exports/pcb-front.pdf

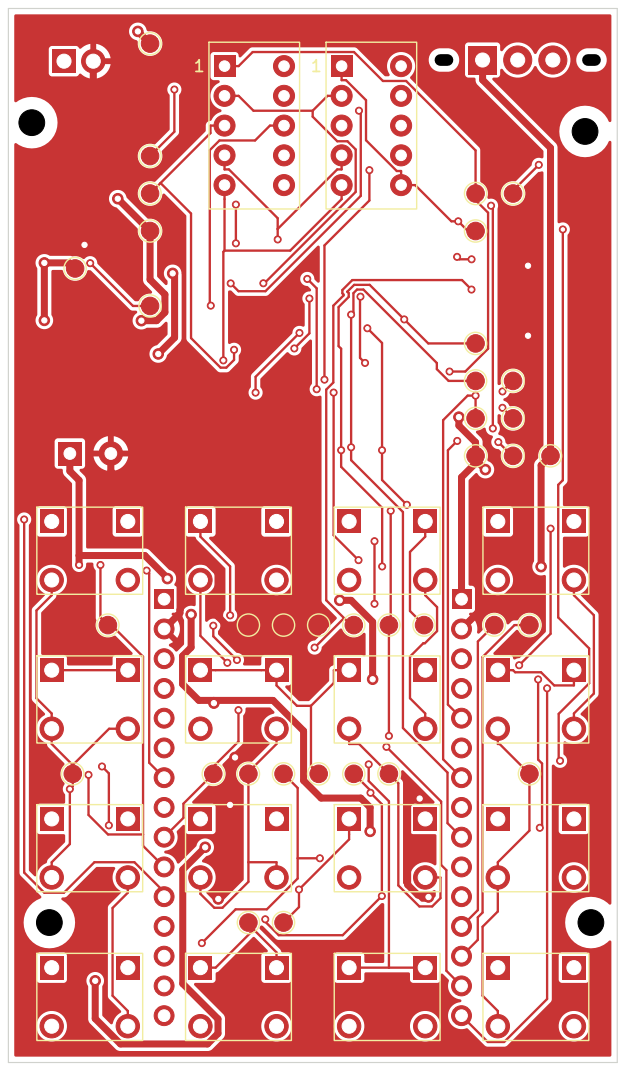
[picture p36: page 1]
