nahhao74/QUIZ_Remote/hardware/single-layer/exports/pcb-back.pdf

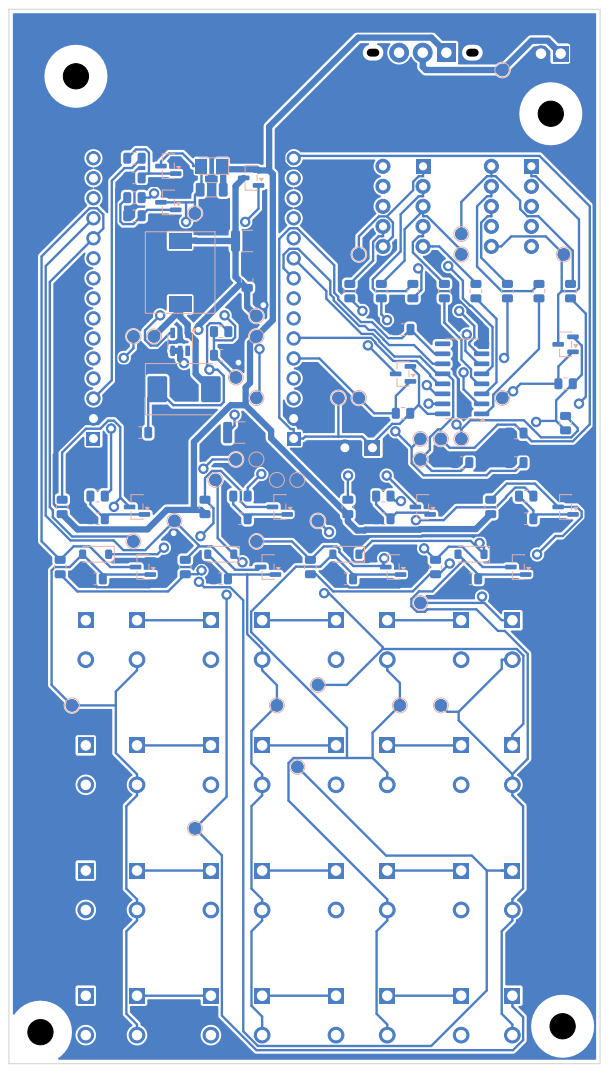
[picture p37: page 1]
