nahhao74/QUIZ_Remote/hardware/single-layer/exports/pcb-front.pdf

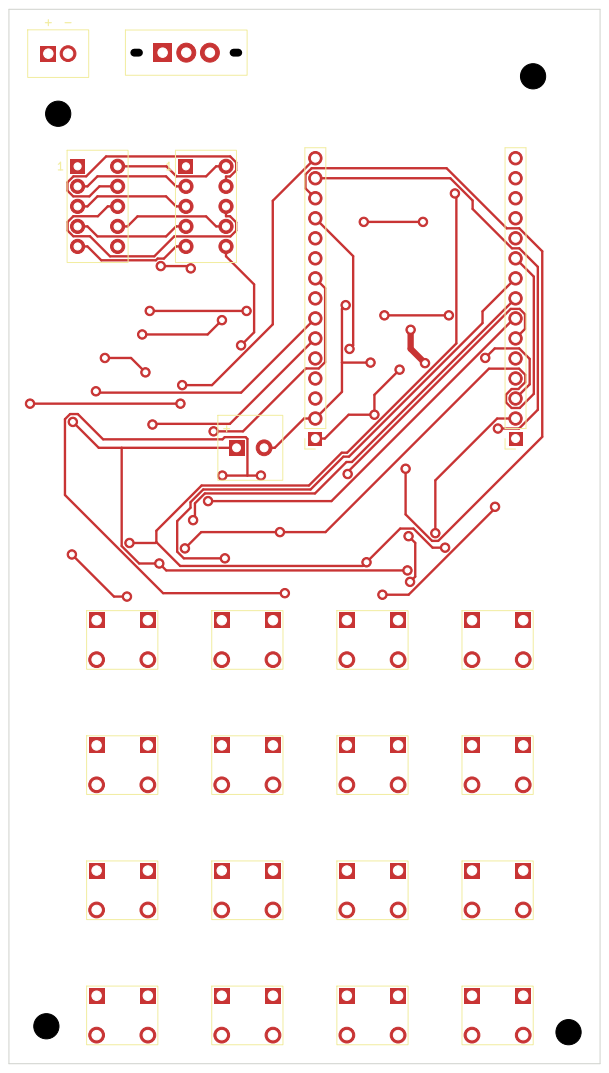
[picture p38: page 1]
