nahhao74/QUIZ_Remote/(list of files, drawings)

Other design files:
hardware/compact/route/quiz_remote.dsn
hardware/single-layer/route/quiz_remote.dsn
quiz_remote_1layer/route/quiz_remote.dsn
quiz_remote_compact/route/quiz_remote.dsn
