nahhao74/QUIZ_Remote/quiz_remote_compact/quiz_remote.kicad_pcb

## KiCad design quiz_remote_compact/quiz_remote.kicad_pcb (2026-10-03)

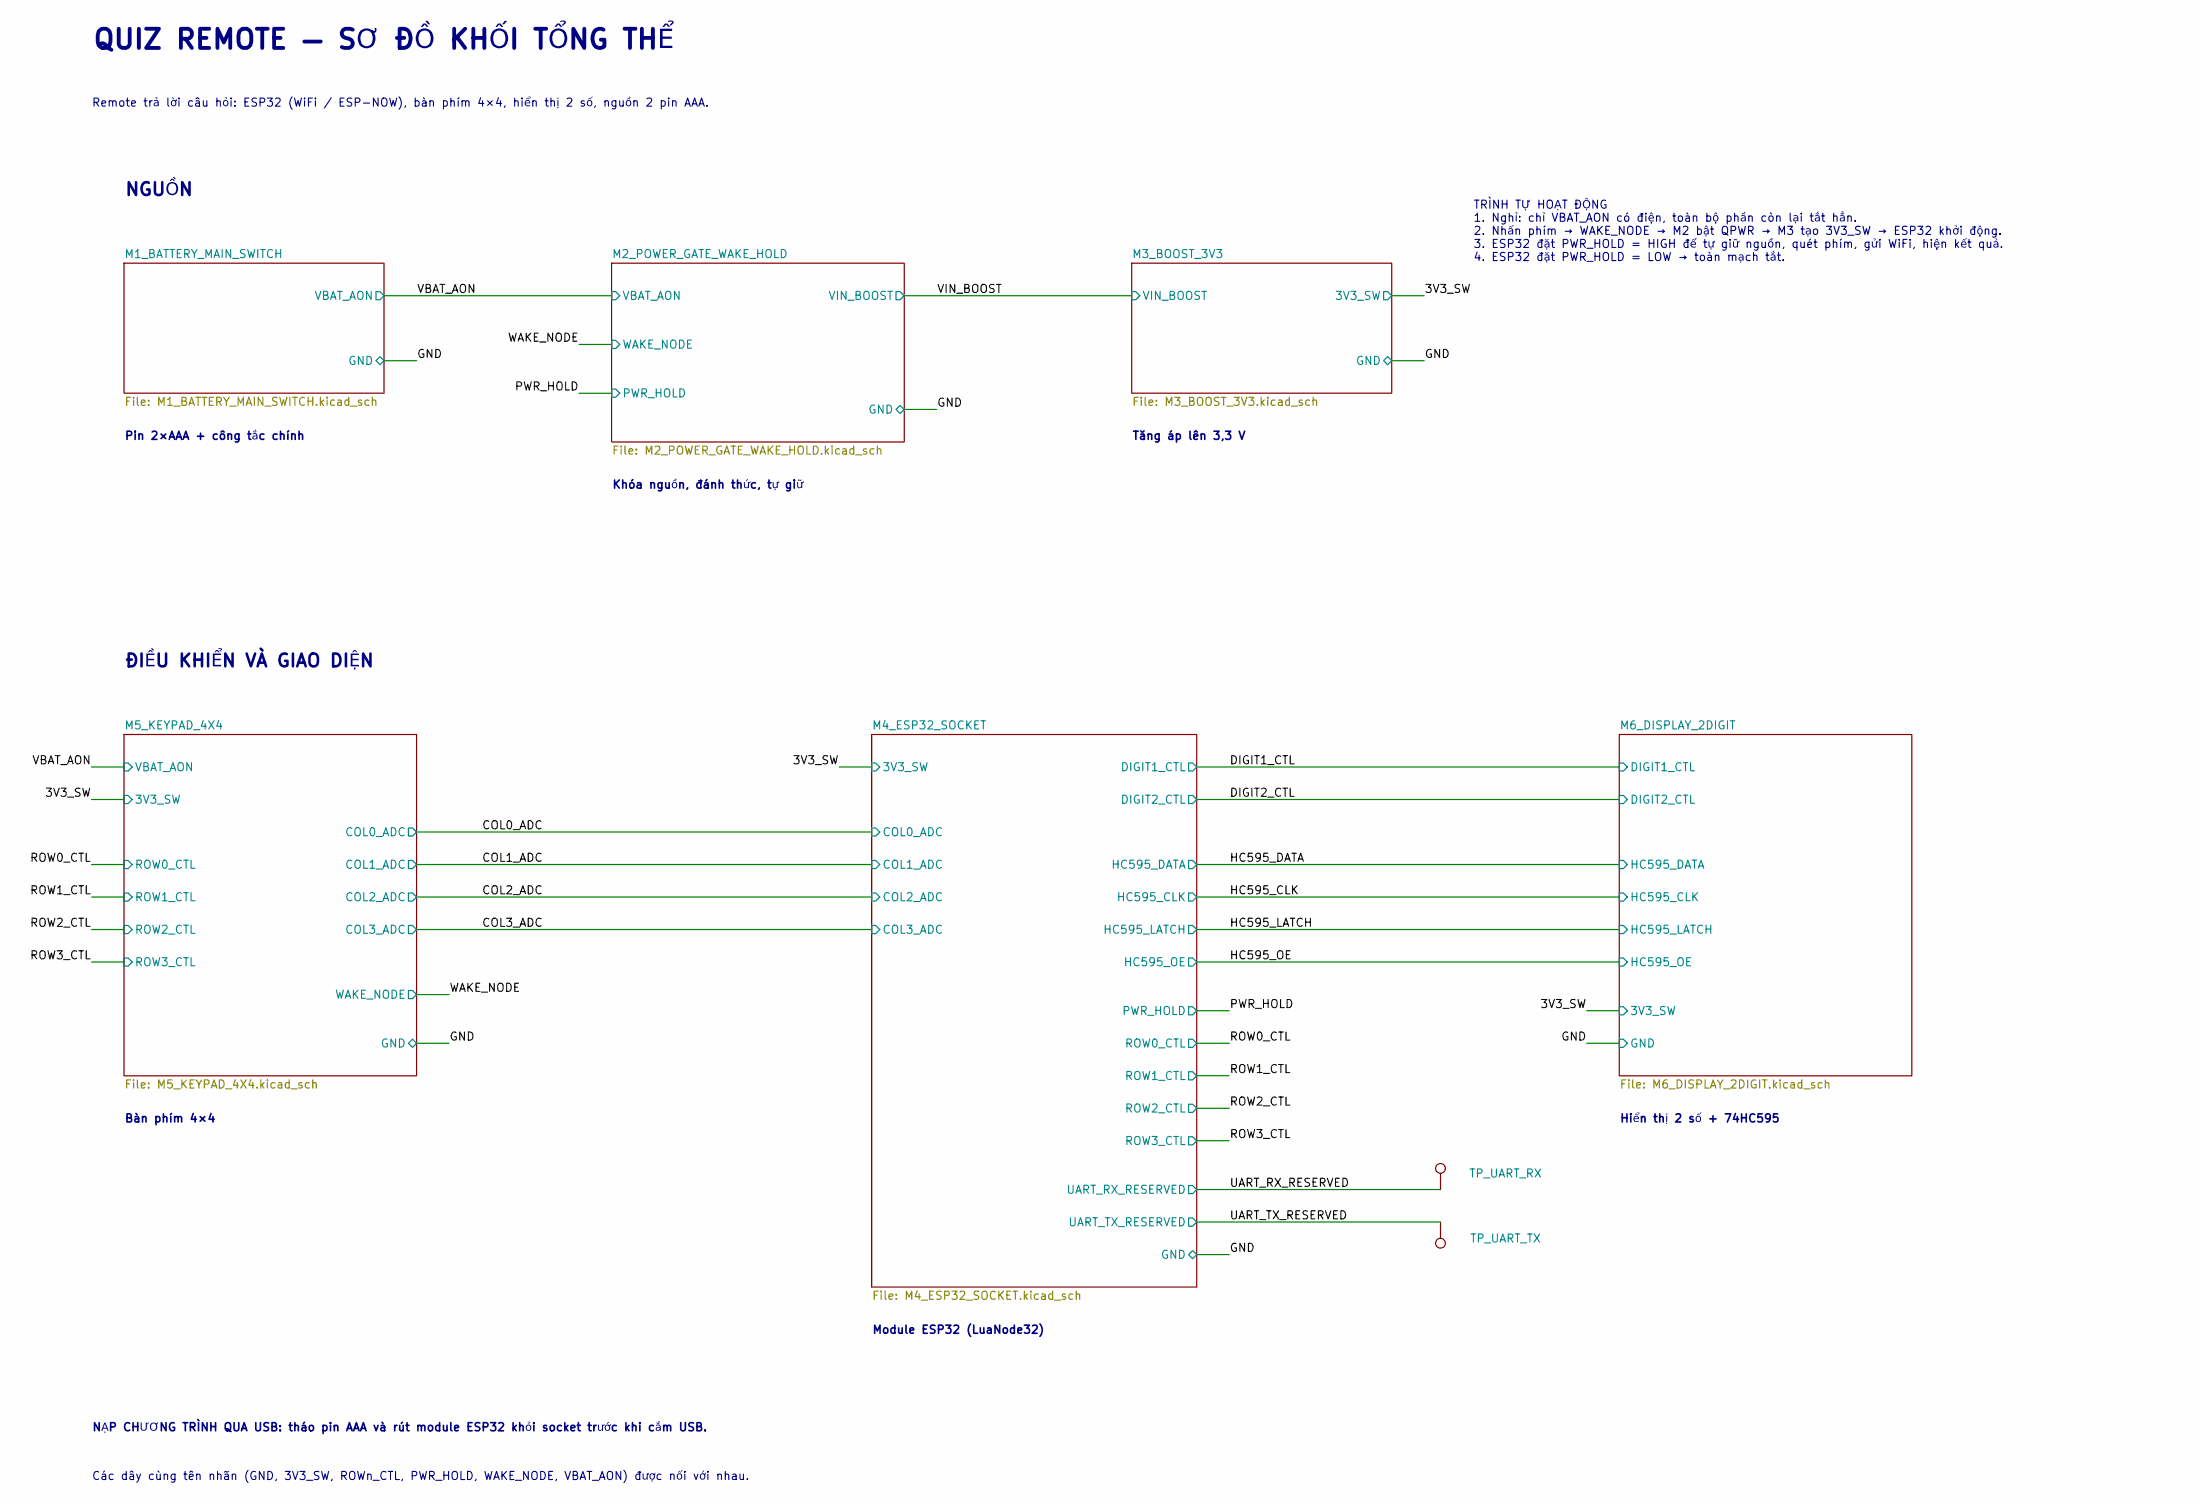
[picture p39: schematic quiz_remote.kicad_sch, QUIZ REMOTE — Sơ đồ khối tổng thể]

Parts:
TP_UART_RX: UART_RX_RESERVED; TestPoint_Pad_D1.5mm
TP_UART_TX: UART_TX_RESERVED; TestPoint_Pad_D1.5mm

Connections:
/UART_RX_RESERVED: TP_UART_RX.1; also elsewhere on the board
/UART_TX_RESERVED: TP_UART_TX.1; also elsewhere on the board

Notes on the sheet:
Pin 2×AAA + công tắc chính
Khóa nguồn, đánh thức, tự giữ
Tăng áp lên 3,3 V
Bàn phím 4×4
Module ESP32 (LuaNode32)
Hiển thị 2 số + 74HC595
QUIZ REMOTE — SƠ ĐỒ KHỐI TỔNG THỂ
Remote trả lời câu hỏi: ESP32 (WiFi / ESP-NOW), bàn phím 4×4, hiển thị 2 số, nguồn 2 pin AAA.
NGUỒN
ĐIỀU KHIỂN VÀ GIAO DIỆN
TRÌNH TỰ HOẠT ĐỘNG 1. Nghỉ: chỉ VBAT_AON có điện, toàn bộ phần còn lại tắt hẳn. 2. Nhấn phím → WAKE_NODE → M2 bật QPWR → M3 tạo 3V3_SW → ESP32 khởi động. 3. ESP32 đặt PWR_HOLD = HIGH để tự giữ nguồn, quét phím, gửi WiFi, hiện kết quả. 4. ESP32 đặt PWR_HOLD = LOW → toàn mạch tắt.
NẠP CHƯƠNG TRÌNH QUA USB: tháo pin AAA và rút module ESP32 khỏi socket trước khi cắm USB.
Các dây cùng tên nhãn (GND, 3V3_SW, ROWn_CTL, PWR_HOLD, WAKE_NODE, VBAT_AON) được nối với nhau.

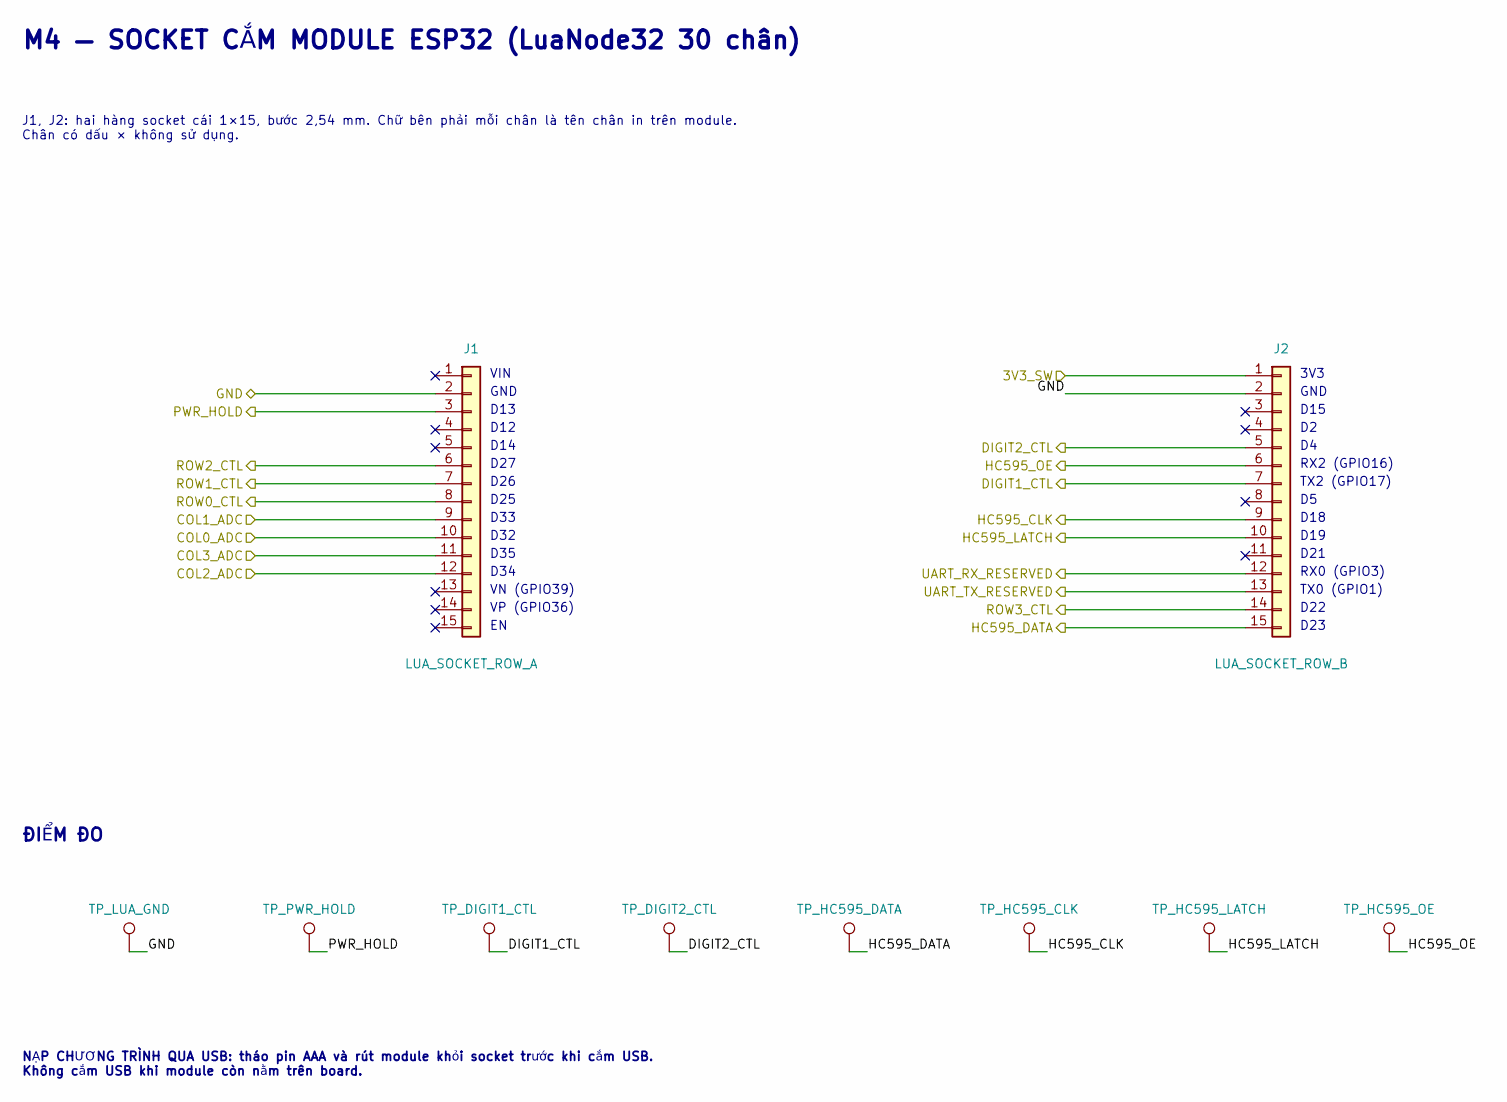
[picture p40: schematic M4_ESP32_SOCKET.kicad_sch, M4 — Socket module ESP32]

Parts:
J1: LUA_SOCKET_ROW_A; PinSocket_1x15_P2.54mm_Vertical; MPN 1x40_female_2.54_11.8_cut15
J2: LUA_SOCKET_ROW_B; PinSocket_1x15_P2.54mm_Vertical; MPN 1x40_female_2.54_11.8_cut15
TP_DIGIT1_CTL: DIGIT1_CTL; TestPoint_Pad_D1.5mm
TP_DIGIT2_CTL: DIGIT2_CTL; TestPoint_Pad_D1.5mm
TP_HC595_CLK: HC595_CLK; TestPoint_Pad_D1.5mm
TP_HC595_DATA: HC595_DATA; TestPoint_Pad_D1.5mm
TP_HC595_LATCH: HC595_LATCH; TestPoint_Pad_D1.5mm
TP_HC595_OE: HC595_OE; TestPoint_Pad_D1.5mm
TP_LUA_GND: GND; TestPoint_Pad_D1.5mm
TP_PWR_HOLD: PWR_HOLD; TestPoint_Pad_D1.5mm

Connections:
/3V3_SW: J2.1; also elsewhere on the board
/COL0_ADC: J1.10; also elsewhere on the board
/COL1_ADC: J1.9; also elsewhere on the board
/COL2_ADC: J1.12; also elsewhere on the board
/COL3_ADC: J1.11; also elsewhere on the board
/DIGIT1_CTL: J2.7, TP_DIGIT1_CTL.1; also elsewhere on the board
/DIGIT2_CTL: J2.5, TP_DIGIT2_CTL.1; also elsewhere on the board
/HC595_CLK: J2.9, TP_HC595_CLK.1; also elsewhere on the board
/HC595_DATA: J2.15, TP_HC595_DATA.1; also elsewhere on the board
/HC595_LATCH: J2.10, TP_HC595_LATCH.1; also elsewhere on the board
/HC595_OE: J2.6, TP_HC595_OE.1; also elsewhere on the board
/PWR_HOLD: J1.3, TP_PWR_HOLD.1; also elsewhere on the board
/ROW0_CTL: J1.8; also elsewhere on the board
/ROW1_CTL: J1.7; also elsewhere on the board
/ROW2_CTL: J1.6; also elsewhere on the board
/ROW3_CTL: J2.14; also elsewhere on the board
/UART_RX_RESERVED: J2.12; also elsewhere on the board
/UART_TX_RESERVED: J2.13; also elsewhere on the board

Notes on the sheet:
VIN
GND
D13
D12
D14
D27
D26
D25
D33
D32
D35
D34
VN (GPIO39)
VP (GPIO36)
3V3
D15
RX2 (GPIO16)
TX2 (GPIO17)
D18
D19
D21
RX0 (GPIO3)
TX0 (GPIO1)
D22
D23
M4 — SOCKET CẮM MODULE ESP32 (LuaNode32 30 chân)
J1, J2: hai hàng socket cái 1×15, bước 2,54 mm. Chữ bên phải mỗi chân là tên chân in trên module. Chân có dấu × không sử dụng.
ĐIỂM ĐO
NẠP CHƯƠNG TRÌNH QUA USB: tháo pin AAA và rút module khỏi socket trước khi cắm USB. Không cắm USB khi module còn nằm trên board.

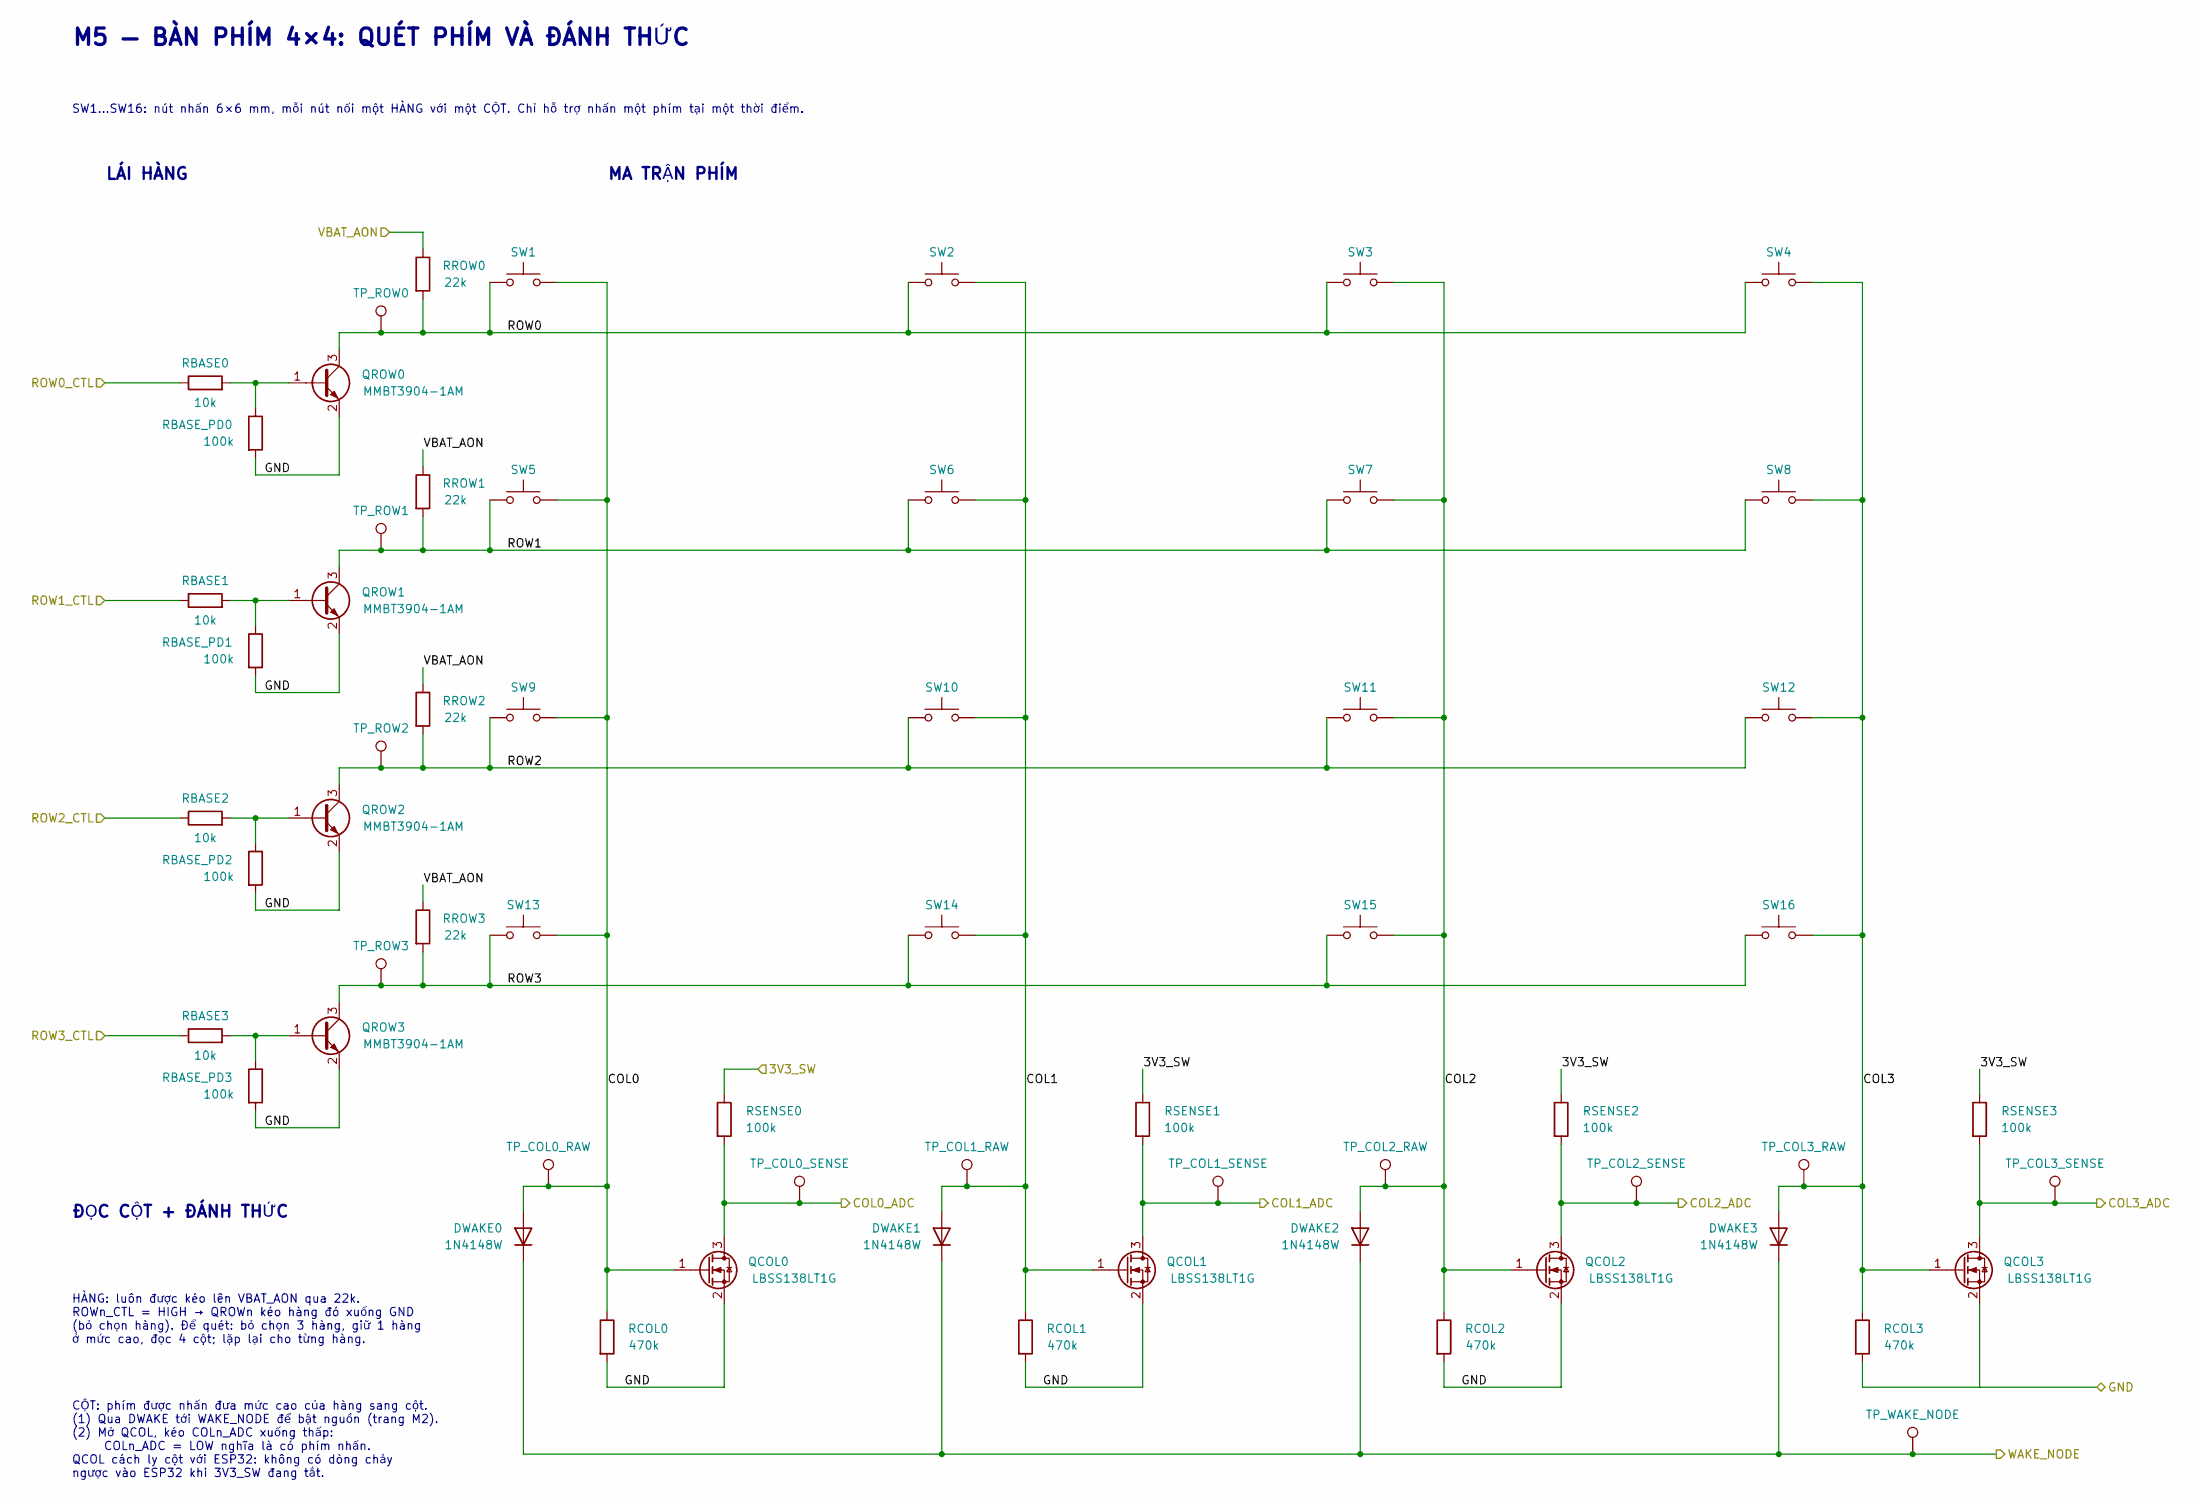
[picture p41: schematic M5_KEYPAD_4X4.kicad_sch, M5 — Bàn phím 4×4]

Parts:
DWAKE0, DWAKE1, DWAKE2, DWAKE3: 1N4148W; D_SOD-123; MPN 1N4148W-E3-18
QCOL0, QCOL1, QCOL2, QCOL3: LBSS138LT1G; SOT-23; MPN LBSS138LT1G
QROW0, QROW1, QROW2, QROW3: MMBT3904-1AM; SOT-23; MPN MMBT3904,215
RBASE0, RBASE1, RBASE2, RBASE3: 10k; R_0805_2012Metric; MPN RC0805FR-0710KL
RBASE_PD0, RBASE_PD1, RBASE_PD2, RBASE_PD3: 100k; R_0805_2012Metric; MPN RC0805FR-07100KL
RCOL0, RCOL1, RCOL2, RCOL3: 470k; R_0805_2012Metric; MPN RC0805FR-07470KL
RROW0, RROW1, RROW2, RROW3: 22k; R_0805_2012Metric; MPN RC0805FR-0722KL
RSENSE0, RSENSE1, RSENSE2, RSENSE3: 100k; R_0805_2012Metric; MPN RC0805FR-07100KL
SW1, SW2, SW3, SW4, SW5, SW6, SW7, SW8, SW9, SW10, SW11, SW12, SW13, SW14, SW15, SW16: 6x6_THT_NO; SW_6x6_H4.3_LK14489; MPN LK14489
TP_COL0_RAW: COL0; TestPoint_Pad_D1.5mm
TP_COL0_SENSE: COL0_ADC; TestPoint_Pad_D1.5mm
TP_COL1_RAW: COL1; TestPoint_Pad_D1.5mm
TP_COL1_SENSE: COL1_ADC; TestPoint_Pad_D1.5mm
TP_COL2_RAW: COL2; TestPoint_Pad_D1.5mm
TP_COL2_SENSE: COL2_ADC; TestPoint_Pad_D1.5mm
TP_COL3_RAW: COL3; TestPoint_Pad_D1.5mm
TP_COL3_SENSE: COL3_ADC; TestPoint_Pad_D1.5mm
TP_ROW0: ROW0; TestPoint_Pad_D1.5mm
TP_ROW1: ROW1; TestPoint_Pad_D1.5mm
TP_ROW2: ROW2; TestPoint_Pad_D1.5mm
TP_ROW3: ROW3; TestPoint_Pad_D1.5mm
TP_WAKE_NODE: WAKE_NODE; TestPoint_Pad_D1.5mm

Connections:
/3V3_SW: RSENSE0.1, RSENSE1.1, RSENSE2.1, RSENSE3.1; also elsewhere on the board
/COL0_ADC: QCOL0.3 (D), RSENSE0.2, TP_COL0_SENSE.1; also elsewhere on the board
/COL1_ADC: QCOL1.3 (D), RSENSE1.2, TP_COL1_SENSE.1; also elsewhere on the board
/COL2_ADC: QCOL2.3 (D), RSENSE2.2, TP_COL2_SENSE.1; also elsewhere on the board
/COL3_ADC: QCOL3.3 (D), RSENSE3.2, TP_COL3_SENSE.1; also elsewhere on the board
/M5_KEYPAD_4X4/COL0: DWAKE0.2 (A), QCOL0.1 (G), RCOL0.1, SW1.2, SW5.2, SW9.2, SW13.2, TP_COL0_RAW.1
/M5_KEYPAD_4X4/COL1: DWAKE1.2 (A), QCOL1.1 (G), RCOL1.1, SW2.2, SW6.2, SW10.2, SW14.2, TP_COL1_RAW.1
/M5_KEYPAD_4X4/COL2: DWAKE2.2 (A), QCOL2.1 (G), RCOL2.1, SW3.2, SW7.2, SW11.2, SW15.2, TP_COL2_RAW.1
/M5_KEYPAD_4X4/COL3: DWAKE3.2 (A), QCOL3.1 (G), RCOL3.1, SW4.2, SW8.2, SW12.2, SW16.2, TP_COL3_RAW.1
/M5_KEYPAD_4X4/ROW0: QROW0.3 (C), RROW0.2, SW1.1, SW2.1, SW3.1, SW4.1, TP_ROW0.1
/M5_KEYPAD_4X4/ROW1: QROW1.3 (C), RROW1.2, SW5.1, SW6.1, SW7.1, SW8.1, TP_ROW1.1
/M5_KEYPAD_4X4/ROW2: QROW2.3 (C), RROW2.2, SW9.1, SW10.1, SW11.1, SW12.1, TP_ROW2.1
/M5_KEYPAD_4X4/ROW3: QROW3.3 (C), RROW3.2, SW13.1, SW14.1, SW15.1, SW16.1, TP_ROW3.1
/ROW0_CTL: RBASE0.1; also elsewhere on the board
/ROW1_CTL: RBASE1.1; also elsewhere on the board
/ROW2_CTL: RBASE2.1; also elsewhere on the board
/ROW3_CTL: RBASE3.1; also elsewhere on the board
/VBAT_AON: RROW0.1, RROW1.1, RROW2.1, RROW3.1; also elsewhere on the board
/WAKE_NODE: DWAKE0.1 (K), DWAKE1.1 (K), DWAKE2.1 (K), DWAKE3.1 (K), TP_WAKE_NODE.1; also elsewhere on the board
unnamed: QROW0.1 (B), RBASE0.2, RBASE_PD0.1
unnamed: QROW1.1 (B), RBASE1.2, RBASE_PD1.1
unnamed: QROW2.1 (B), RBASE2.2, RBASE_PD2.1
unnamed: QROW3.1 (B), RBASE3.2, RBASE_PD3.1

Notes on the sheet:
M5 — BÀN PHÍM 4×4: QUÉT PHÍM VÀ ĐÁNH THỨC
SW1…SW16: nút nhấn 6×6 mm, mỗi nút nối một HÀNG với một CỘT. Chỉ hỗ trợ nhấn một phím tại một thời điểm.
LÁI HÀNG
MA TRẬN PHÍM
ĐỌC CỘT + ĐÁNH THỨC
HÀNG: luôn được kéo lên VBAT_AON qua 22k. ROWn_CTL = HIGH → QROWn kéo hàng đó xuống GND (bỏ chọn hàng). Để quét: bỏ chọn 3 hàng, giữ 1 hàng ở mức cao, đọc 4 cột; lặp lại cho từng hàng.
CỘT: phím được nhấn đưa mức cao của hàng sang cột. (1) Qua DWAKE tới WAKE_NODE để bật nguồn (trang M2). (2) Mở QCOL, kéo COLn_ADC xuống thấp: COLn_ADC = LOW nghĩa là có phím nhấn. QCOL cách ly cột với ESP32: không có dòng chảy ngược vào ESP32 khi 3V3_SW đang tắt.

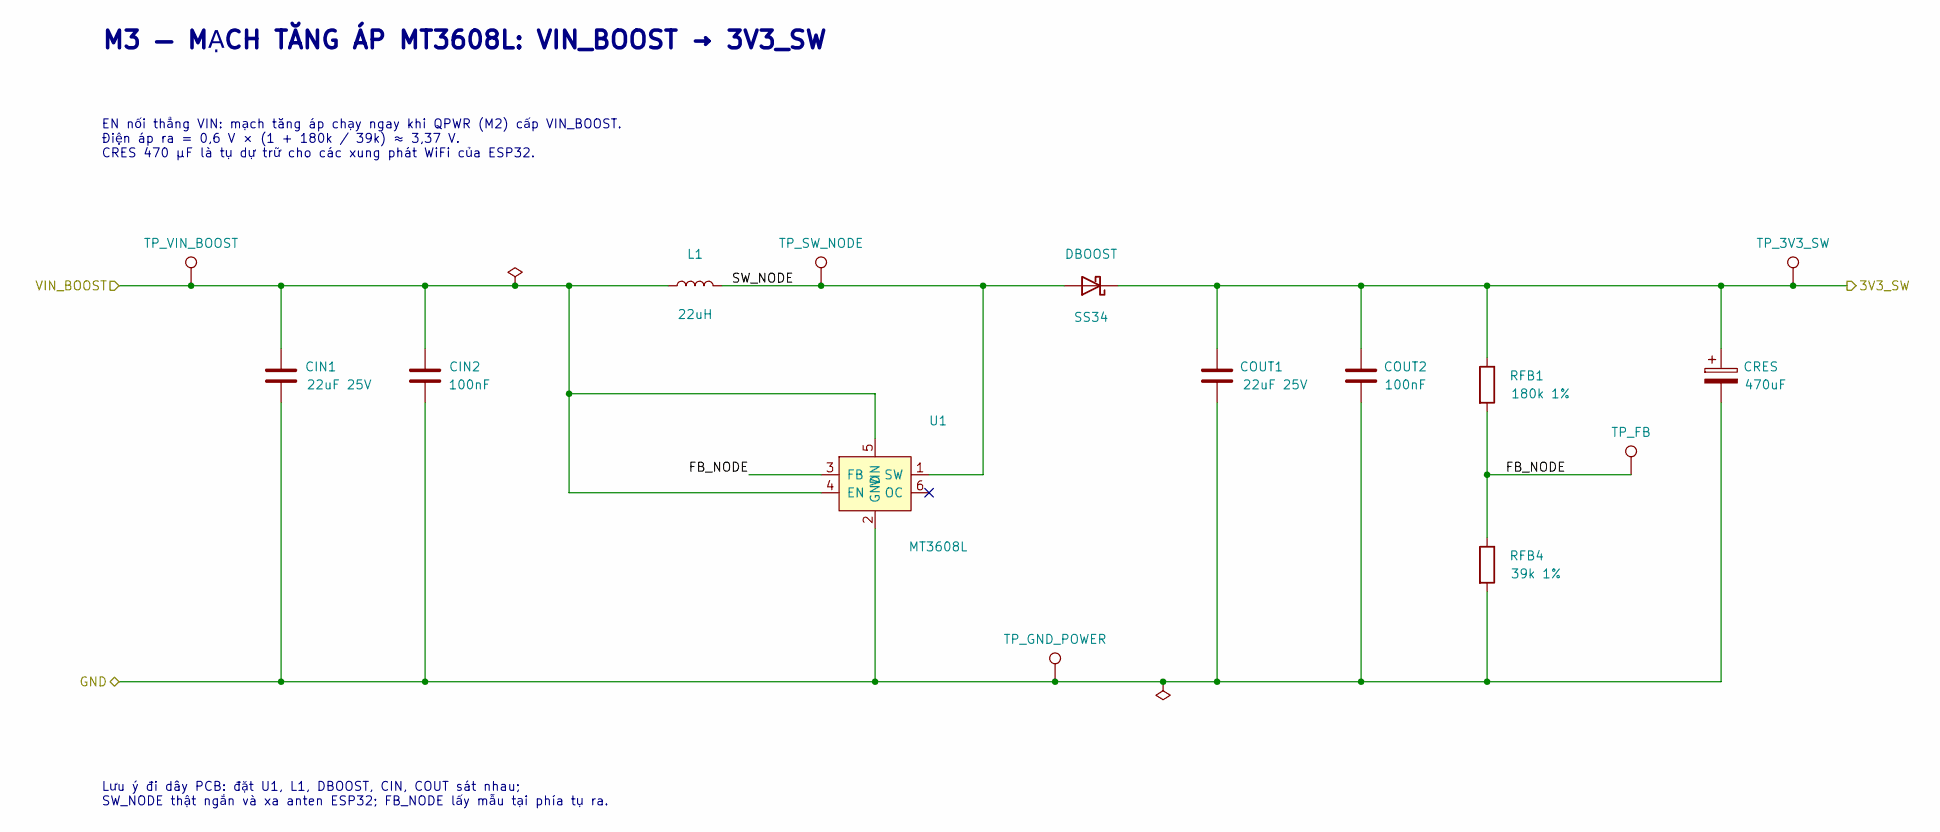
[picture p42: schematic M3_BOOST_3V3.kicad_sch, M3 — Tăng áp MT3608L 3,3 V]

Parts:
CIN1: 22uF 25V; C_1210_3225Metric; Ratings 22uF25V1210; vendorSKUidentityonly; eff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; MPN Supplier_22uF_25V_1210
CIN2: 100nF; C_0805_2012Metric; Ratings 100nF +/-10%,50V,X7R,0805; prototype ha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; MPN C0805C104K5RACTU
COUT1: 22uF 25V; C_1210_3225Metric; Ratings 22uF25V1210; vendorSKUidentityonly; eff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; MPN Supplier_22uF_25V_1210
COUT2: 100nF; C_0805_2012Metric; Ratings 100nF +/-10%,50V,X7R,0805; prototype ha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; MPN C0805C104K5RACTU
CRES: 470uF; CRES_IC4172_D8_P3.50_Prototype; Ratings 470uF16V+/-20%,D8H12.5P3.5; noESRinferr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; MPN IC4172_supplier_identity_NO_exact_MPN
DBOOST: SS34; D_SMC; MPN SS34-E3/57T
L1: 22uH; L_8D43_220_ThegioiIC; Ratings 22uH3.25Alisted;protoaccepted; drawingt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; MPN 8D43-220
RFB1: 180k 1%; R_0805_2012Metric; MPN RC0805FR-07180KL
RFB4: 39k 1%; R_0805_2012Metric; MPN RC0805FR-0739KL
TP_3V3_SW: 3V3_SW; TestPoint_Pad_D1.5mm
TP_FB: FB_NODE; TestPoint_Pad_D1.5mm
TP_GND_POWER: GND; TestPoint_Pad_D1.5mm
TP_SW_NODE: SW_NODE; TestPoint_Pad_D1.5mm
TP_VIN_BOOST: VIN_BOOST; TestPoint_Pad_D1.5mm
U1: MT3608L; SOT-23-6; MPN MT3608L

Connections:
/3V3_SW: COUT1.1, COUT2.1, CRES.1, DBOOST.1 (K), RFB1.1, TP_3V3_SW.1; also elsewhere on the board
/M3_BOOST_3V3/FB_NODE: RFB1.2, RFB4.1, TP_FB.1, U1.3 (FB)
/M3_BOOST_3V3/SW_NODE: DBOOST.2 (A), L1.2, TP_SW_NODE.1, U1.1 (SW)

Notes on the sheet:
M3 — MẠCH TĂNG ÁP MT3608L: VIN_BOOST → 3V3_SW
EN nối thẳng VIN: mạch tăng áp chạy ngay khi QPWR (M2) cấp VIN_BOOST. Điện áp ra = 0,6 V × (1 + 180k / 39k) ≈ 3,37 V. CRES 470 µF là tụ dự trữ cho các xung phát WiFi của ESP32.
Lưu ý đi dây PCB: đặt U1, L1, DBOOST, CIN, COUT sát nhau; SW_NODE thật ngắn và xa anten ESP32; FB_NODE lấy mẫu tại phía tụ ra.

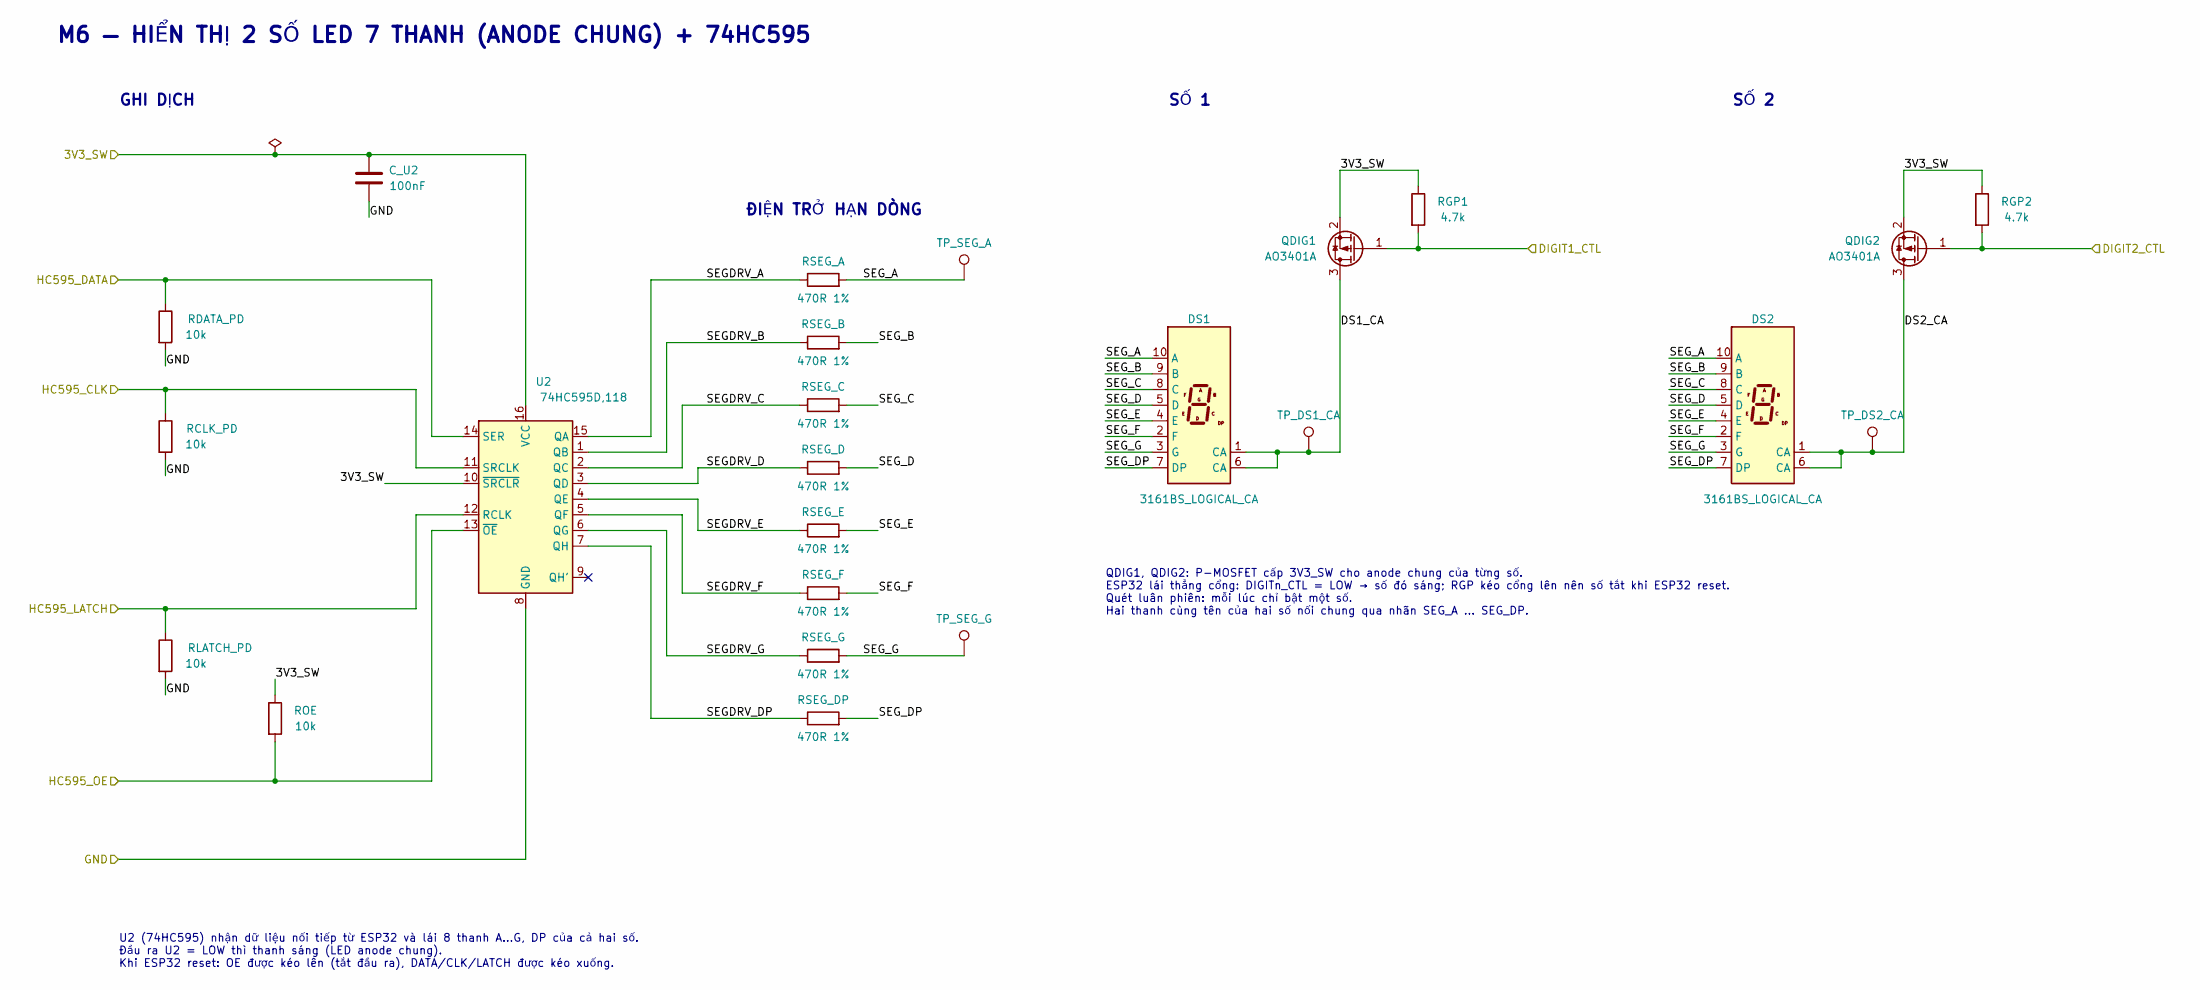
[picture p43: schematic M6_DISPLAY_2DIGIT.kicad_sch, M6 — Hiển thị 2 số + 74HC595]

Parts:
C_U2: 100nF; C_0805_2012Metric; Ratings 100nF +/-10%,50V,X7R,0805; prototype ha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; MPN C0805C104K5RACTU
DS1, DS2: 3161BS_LOGICAL_CA; Display_XLITX_3161BS; MPN 3161BS
QDIG1, QDIG2: AO3401A; SOT-23; MPN AO3401A
RCLK_PD: 10k; R_0805_2012Metric; MPN RC0805FR-0710KL
RDATA_PD: 10k; R_0805_2012Metric; MPN RC0805FR-0710KL
RGP1, RGP2: 4.7k; R_0805_2012Metric; MPN RC0805FR-074K7L
RLATCH_PD: 10k; R_0805_2012Metric; MPN RC0805FR-0710KL
ROE: 10k; R_0805_2012Metric; MPN RC0805FR-0710KL
RSEG_A: 470R 1%; R_0805_2012Metric; MPN RC0805FR-07470RL
RSEG_B: 470R 1%; R_0805_2012Metric; MPN RC0805FR-07470RL
RSEG_C: 470R 1%; R_0805_2012Metric; MPN RC0805FR-07470RL
RSEG_D: 470R 1%; R_0805_2012Metric; MPN RC0805FR-07470RL
RSEG_DP: 470R 1%; R_0805_2012Metric; MPN RC0805FR-07470RL
RSEG_E: 470R 1%; R_0805_2012Metric; MPN RC0805FR-07470RL
RSEG_F: 470R 1%; R_0805_2012Metric; MPN RC0805FR-07470RL
RSEG_G: 470R 1%; R_0805_2012Metric; MPN RC0805FR-07470RL
TP_DS1_CA: TP_DS1_CA; TestPoint_Pad_D1.5mm
TP_DS2_CA: TP_DS2_CA; TestPoint_Pad_D1.5mm
TP_SEG_A: TP_SEG_A; TestPoint_Pad_D1.5mm
TP_SEG_G: TP_SEG_G; TestPoint_Pad_D1.5mm
U2: 74HC595D,118; SOIC-16_3.9x9.9mm_P1.27mm; MPN 74HC595D,118

Connections:
/3V3_SW: C_U2.1, QDIG1.2 (S), QDIG2.2 (S), RGP1.1, RGP2.1, ROE.1, U2.10 (~SRCLR), U2.16 (VCC); also elsewhere on the board
/DIGIT1_CTL: QDIG1.1 (G), RGP1.2; also elsewhere on the board
/DIGIT2_CTL: QDIG2.1 (G), RGP2.2; also elsewhere on the board
/HC595_CLK: RCLK_PD.1, U2.11 (SRCLK); also elsewhere on the board
/HC595_DATA: RDATA_PD.1, U2.14 (SER); also elsewhere on the board
/HC595_LATCH: RLATCH_PD.1, U2.12 (RCLK); also elsewhere on the board
/HC595_OE: ROE.2, U2.13 (~OE); also elsewhere on the board
/M6_DISPLAY_2DIGIT/DS1_CA: DS1.1 (CA), DS1.6 (CA), QDIG1.3 (D), TP_DS1_CA.1
/M6_DISPLAY_2DIGIT/DS2_CA: DS2.1 (CA), DS2.6 (CA), QDIG2.3 (D), TP_DS2_CA.1
/M6_DISPLAY_2DIGIT/SEGDRV_A: RSEG_A.1, U2.15 (QA)
/M6_DISPLAY_2DIGIT/SEGDRV_B: RSEG_B.1, U2.1 (QB)
/M6_DISPLAY_2DIGIT/SEGDRV_C: RSEG_C.1, U2.2 (QC)
/M6_DISPLAY_2DIGIT/SEGDRV_D: RSEG_D.1, U2.3 (QD)
/M6_DISPLAY_2DIGIT/SEGDRV_DP: RSEG_DP.1, U2.7 (QH)
/M6_DISPLAY_2DIGIT/SEGDRV_E: RSEG_E.1, U2.4 (QE)
/M6_DISPLAY_2DIGIT/SEGDRV_F: RSEG_F.1, U2.5 (QF)
/M6_DISPLAY_2DIGIT/SEGDRV_G: RSEG_G.1, U2.6 (QG)
/M6_DISPLAY_2DIGIT/SEG_A: DS1.10 (A), DS2.10 (A), RSEG_A.2, TP_SEG_A.1
/M6_DISPLAY_2DIGIT/SEG_B: DS1.9 (B), DS2.9 (B), RSEG_B.2
/M6_DISPLAY_2DIGIT/SEG_C: DS1.8 (C), DS2.8 (C), RSEG_C.2
/M6_DISPLAY_2DIGIT/SEG_D: DS1.5 (D), DS2.5 (D), RSEG_D.2
/M6_DISPLAY_2DIGIT/SEG_DP: DS1.7 (DP), DS2.7 (DP), RSEG_DP.2
/M6_DISPLAY_2DIGIT/SEG_E: DS1.4 (E), DS2.4 (E), RSEG_E.2
/M6_DISPLAY_2DIGIT/SEG_F: DS1.2 (F), DS2.2 (F), RSEG_F.2
/M6_DISPLAY_2DIGIT/SEG_G: DS1.3 (G), DS2.3 (G), RSEG_G.2, TP_SEG_G.1

Notes on the sheet:
M6 — HIỂN THỊ 2 SỐ LED 7 THANH (ANODE CHUNG) + 74HC595
GHI DỊCH
ĐIỆN TRỞ HẠN DÒNG
SỐ 1
SỐ 2
U2 (74HC595) nhận dữ liệu nối tiếp từ ESP32 và lái 8 thanh A…G, DP của cả hai số. Đầu ra U2 = LOW thì thanh sáng (LED anode chung). Khi ESP32 reset: OE được kéo lên (tắt đầu ra), DATA/CLK/LATCH được kéo xuống.
QDIG1, QDIG2: P-MOSFET cấp 3V3_SW cho anode chung của từng số. ESP32 lái thẳng cổng: DIGITn_CTL = LOW → số đó sáng; RGP kéo cổng lên nên số tắt khi ESP32 reset. Quét luân phiên: mỗi lúc chỉ bật một số. Hai thanh cùng tên của hai số nối chung qua nhãn SEG_A … SEG_DP.

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
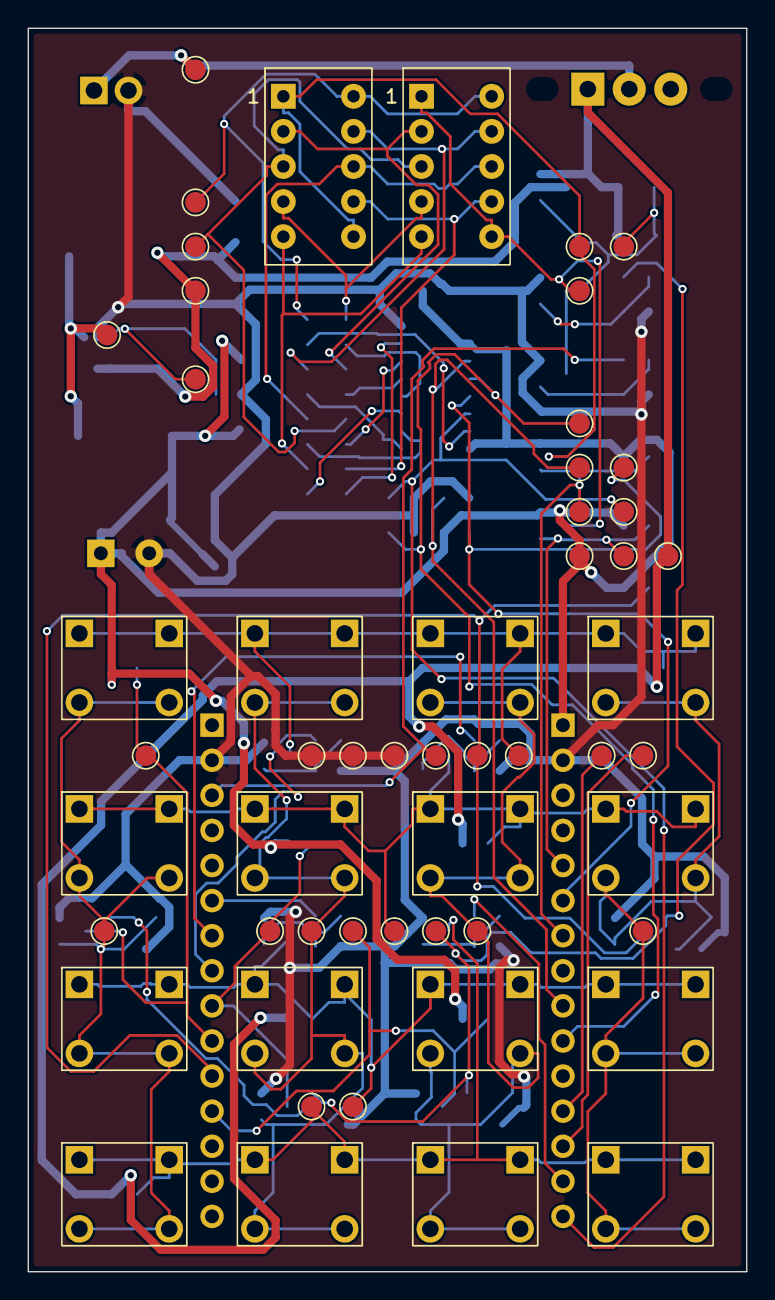
[picture p44: board quiz_remote.kicad_pcb from above]

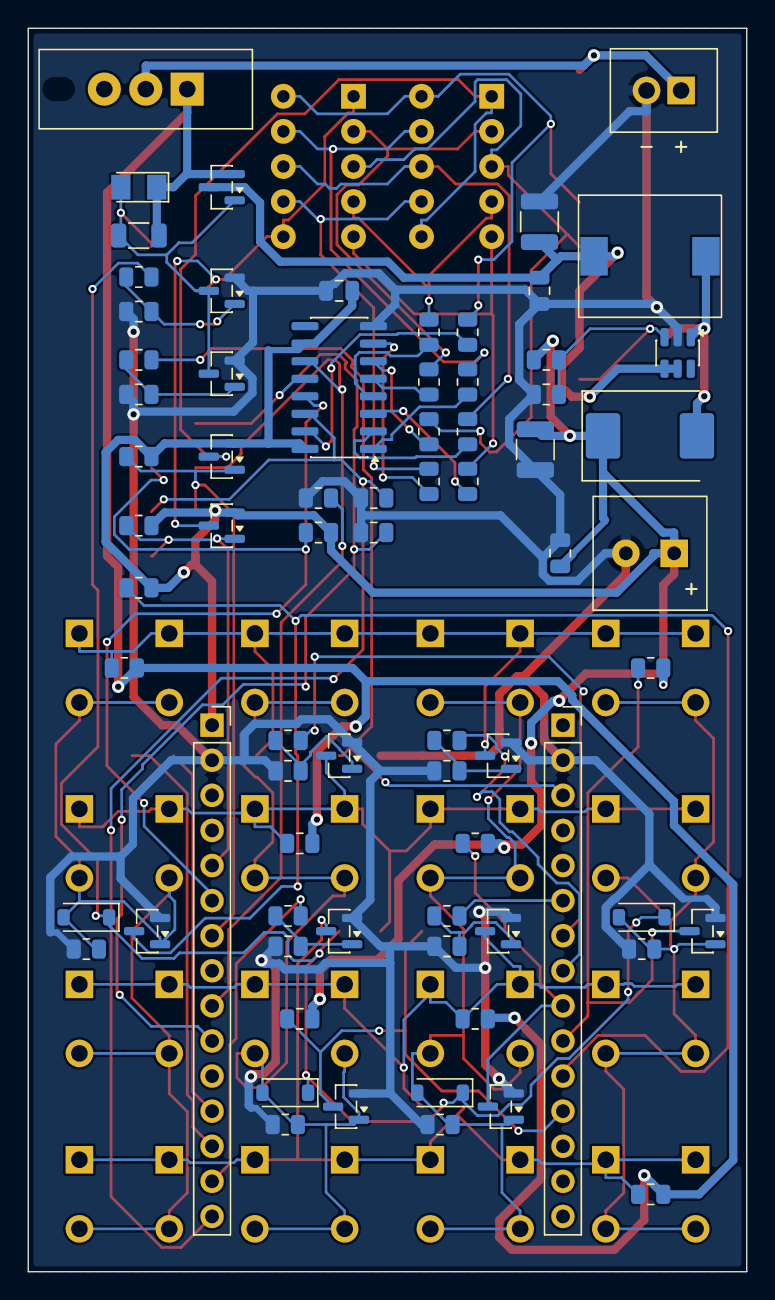
[picture p45: board quiz_remote.kicad_pcb from below]

Board: 2 copper layers, 52.0 x 90.0 mm, 127 parts (73 on the bottom side), 58 nets.

Other parts of the board:
C_GATE: 4.7uF; CP_AVX_TAJ_A_3216_18
JBAT: LK2114_BATTERY; JBAT_LK2114_P2.50_Prototype
QHOLD: MMBT3904; SOT-23
QPWR: AO3401A; SOT-23
QWAKE: MMBT3904; SOT-23
R_GATE: 220k; R_1206_3216Metric
R_HOLD: 10k; R_0805_2012Metric
R_HOLD_PD: 100k; R_0805_2012Metric
R_WAKE: 100k; R_0805_2012Metric
R_WAKE_PD: 1M; R_0805_2012Metric
SW_MAIN: SS-12F23G4; SW_SS12F23G4_LK
TP_GND: GND; TestPoint_Pad_D1.5mm
TP_PWR_GATE: PWR_GATE; TestPoint_Pad_D1.5mm
TP_VBAT_AON: VBAT_AON; TestPoint_Pad_D1.5mm
TP_VBAT_RAW: VBAT_RAW; TestPoint_Pad_D1.5mm

Their connections:
/M1_BATTERY_MAIN_SWITCH/VBAT_RAW: JBAT.1, SW_MAIN.2, TP_VBAT_RAW.1
/M2_POWER_GATE_WAKE_HOLD/PWR_GATE: C_GATE.2, QHOLD.3, QPWR.1, QWAKE.3, R_GATE.2, TP_PWR_GATE.1
/PWR_HOLD: R_HOLD.1; also elsewhere on the board
/VBAT_AON: C_GATE.1, QPWR.2, R_GATE.1, SW_MAIN.1, TP_VBAT_AON.1; also elsewhere on the board
/WAKE_NODE: R_WAKE.1; also elsewhere on the board
unnamed: QHOLD.1, R_HOLD.2, R_HOLD_PD.1
unnamed: QWAKE.1, R_WAKE.2, R_WAKE_PD.1
