nahhao74/QUIZ_Remote/(commit log)

2026-10-07 Add M2 mounting holes with copper keep-out, add single-sided board and Gerber outputs
2026-10-15 Reorganize repository around hardware/ and export docs
    - Move the compact and single-layer KiCad projects and the build scripts under hardware/
    - Add hardware/README.md describing the design process and folder layout
    - Add hardware/tools/export_docs.py: per-sheet schematic PDF/PNG, board front/back PDF/PNG, BOM CSV
    - Merge calculations and BOM into the design document (v1.1); use ASCII minus signs
    - Remove absolute home paths from generated netlist and DSN files
2026-10-15 Drop single-sided board and rewrite READMEs in English
    - Remove hardware/single-layer and its build script from the repository (kept on disk, untracked)
    - Replace the root README with a project overview: function, specs, operating sequence, status
    - Move the design process, KiCad workflow, simulation and export instructions to hardware/README.md
    - Export script covers the compact board only
2026-10-15 Remove redundant route render and solder guide PNGs
    The board views in compact/exports/ replace the render PNGs; the solder
    guide PNGs are regenerated by the build script's solder stage.
2026-10-15 Translate design document and assembly guide to English
    - Rename docs/tai-lieu-thiet-ke-phan-cung.md to docs/design-document.md and translate it (version 1.2)
    - Translate the assembly guide labels and notes in the build script and regenerate the SVG guides
    - Update the README link to the design document
2026-10-15 Add ClassPulse web and ESP32 firmware
2026-10-15 Polish top-level README; update hardware status to match the working board
2026-10-15 Add device photos and app screenshots to the README
